hoglet67/AtomBusMon/README.md

# ICE-T65 / ICE-T80 / ICE-6809

This project is an open-source In-Circuit Emulator for the 6502, 65C02, Z80, 6809 and 6809E 8-bit processors.

For further details see the GitHub Project Wiki:
https://github.com/hoglet67/AtomBusMon/wiki

If you have any questions or feedback, please join in the discussion thread at stardot.org.uk:
http://stardot.org.uk/forums/viewtopic.php?f=44&t=9655
