hoglet67/AtomBusMon/(threads)

Thread 3 (2019-03-29):

Add support 1801BM1 Soviet PDP-11 CPU.

xolod79, 2019-03-29:
Thank you for a very interesting project!
I want to ask you whether you can add support for CPU 1801BM1 in your project.
There is a working model of it https://github.com/1801BM1/cpu11/blob/master/readme.md with configuration for Xilinx devboard
I think that you can transfer it to the GODIL board quickly.
I understand that adding debugging tools is much more difficult. But perhaps gradually it can be done by joint efforts.
If you are interested, I can send you the original of this CPU.

hoglet67, 2019-03-29:
This is not something I'll be able to take on in the short term. I've got too many other projects on the go at the moment. Also, I don't have any experience of this CPU, and no systems that use it. So that's going to make it hard as well. Sorry!

hoglet67, 2019-03-29:
(I'll leave this issue open in case someone else wants to tackle it)

xolod79, 2019-03-29:
Thanks for the answer.
If it will be interesting. Here are some articles on the second model of this CPU.
https://hackaday.io/project/67369/logs?sort=oldest

jessaskey, 2021-04-03:
@xolod79 , I would be interested in trying to add another CPU core to Davids existing codebase in this direction... My cpu is a DEC T-11 is a tad different but in the same 'family'... the soviets cloned the T11 as the KE1807VM1 - https://en.wikipedia.org/wiki/DEC_T-11

and the core I found which might be a template is here.... https://opencores.org/projects/w11

xolod79, 2021-04-03:
hello @jessaskey! I love your interest in porting DEC T11 to Atom Bus! I have a Soviet computer Electronics MC0515 with KR1807VM1 as a CPU. http://www.leningrad.su/museum/show_calc.php?n=267&lang=0&test=0
And I can test the results obtained if you wish.
Yes, of course, you will have to expand the work of the respected @ hoglet67 to integrate the 16bit CPU DEC, but I suppose that there should not be something very complicated there.
I also want to draw your attention to the project https://github.com/1801BM1/cpu11 where, using DECAP and reverse engineering, accurate transistor circuits and Verlog LSI-11 and original Soviet PDP-11 CPUs were obtained. Also the author of the project will soon complete the DEC F-11.

jessaskey, 2021-04-04:
Just to put this link here for reference... here the best source for T-11 datasheets...  http://bitsavers.informatik.uni-stuttgart.de/pdf/dec/pdp11/t11/

when I have time, I will start looking at this and how it might fit onto an EEPIZZA Spartan, then start trimming the above core down.

Thread 4 (2019-04-02):

ICE-Z80 and the Micro-Professor MPF-1

AFA58, 2019-04-02:
Maybe I look wring,but I can not find an index of wikipages that are here. I am going to build a ICE-Z80 with a 500. What I found until now is:
https://github.com/hoglet67/AtomBusMon/wiki		HOME
https://github.com/hoglet67/AtomBusMon/wiki/Compiling-firmware
https://github.com/hoglet67/AtomBusMon/wiki/Firmware-Overview
https://github.com/hoglet67/AtomBusMon/wiki/Toolchain
https://github.com/hoglet67/AtomBusMon/wiki/ICE-T80
Is there more available?

And something else:
I like the adapter board that  joeyoravec made, see page 21 of stardot.org. Tobe able to contact him, you need to register as a member on stardot.org. The registration has to be approved. I guess there is nobody homeanymore because the registrattion does not proceed, so I can  not contact joeyoravec.
Any suggestion on this?  His adapterboard looks cool

hoglet67, 2019-04-02:
There are 19 pages on the Wiki; all can be seen in the sidebar on the right of the Wiki.

Are you not seeing this navigation aid?

hoglet67, 2019-04-02:
What user name did you register under - I'll get it approved for you.

AFA58, 2019-04-03:
Hi David,

Name is AFA58. Now I see i was using IE. When I use opera I see the
sidebar with the content.

I could not understand why I did not see, I guess IE messes it up. (Need
it for work though, so what can you do)

Thanks!

Ton

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

Links:
------
[1]
https://github.com/hoglet67/AtomBusMon/issues/4#issuecomment-479180105
[2]
https://github.com/notifications/unsubscribe-auth/AEXiv_5rOQ1U-VnkN9VZCBf7Wj3hnJKDks5vc7oPgaJpZM4cY_c0

AFA58, 2019-04-06:
Hi David,

According to the wiki pages you install Xilinx ISE 14.7 on Ubuntu 14.04.

When I do that the USB cable can not work because the windrv6 is not
installed.

Checking Google gives many pages but no solution, I knowafter three/four
hours.

How didyou get the USB Cable to work in this set up?

Regards,
Ton

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

Links:
------
[1]
https://github.com/hoglet67/AtomBusMon/issues/4#issuecomment-479180105
[2]
https://github.com/notifications/unsubscribe-auth/AEXiv_5rOQ1U-VnkN9VZCBf7Wj3hnJKDks5vc7oPgaJpZM4cY_c0

hoglet67, 2019-04-07:
You need to compile and install a third-party USB cable driver (called "libusb-driver")

There are lots of instructions for this on the web, but they do var depending on the exact version of Ubuntu that you are using, and whether it's 32-bit or 64-bit.

Try this one:
https://www.george-smart.co.uk/fpga/xilinx_jtag_linux/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

AFA58, 2019-04-16:
The first link worked like a charm, I am able to use the cable now.
Thanks!

First I programmed the 500-GODIL with blank.mcs and after that with avrz80cpu.mcs. When I power up the GODIL I receive the startup message on the serial port, free running CPU, and I can get a working prompt.

I made a adapter PCB so the two 50P female connectors on the bottom of the GODIL are connected to a 40P DIP socket. (Aligned by the VCC and GND pins, leaving the top 3 and bottom 2 pinrows of the 50P empty)

I expect the thing to run then. For testing I use a Micro Professor, which is a very basic Z80 system, 1,7Mhz, no buffering of Address or Databus, other than 10K pull-ups on the databus.

But it does not run. The MPF does not start up and I do not see any activity on any pin. When I do a memdump I only see 00 everywhere.

Am I missing something? Is programming with avrz80cpu.mcs all I have to do, or is there more?

hoglet67, 2019-04-16:
Programming with  avrz80cpu.mcs is all you should need to do.

When you do a memory dump at location 0 I would expect you would see the ROM.

So something is not right.

In the serial console, can you do the following:
- <hit return to get to interactive mode>
- reset
- regs
- step 10
- regs
- continue

and post a log of the full session.

Do you have access to an oscilloscope?

AFA58, 2019-04-16:
I think I know what is wrong: I expected that the dip40 would follow the pinning of the two 50P connectors.

That leaves 3 empty pins on the top free and two on the bottom.

BUT.. on the schematics, now I see that C13 is connected to pin49, and D13 is connected to pin50.
(C13 and D13 being pins on the two 50P female connectors.

That means that the Pin1 to 10 of the z80, and also pin 31 to 40 are wired wrong, they should go to one pin higher of the 50P headers. (C13 and D13 should have been left unconnected).
Weird why pin49 and pin50 are put inbetween on the D50 connectors, but not on the DIL40. I should have seen it on the schematics though... But in dutch it is "in hindsight you look the cow in its ass".

Anyway, two options: Solder a new adapter PCB. (but more difficult because of the 1 pin offset on the top-half)  Or changing the pinning of the emulated Z80 to include the pin49 and pin50. And rebuild etc. (Need to read into that, whether that is easy)

hoglet67, 2019-04-16:
The symptoms you reported were consistent with the core not receiving a clock.

Changing the pinout in the .ucf file to mach your adaptor should be possible.

Just edit the LOC= values in this file:
https://github.com/hoglet67/AtomBusMon/blob/master/target/godil_500/icez80/board.ucf

hoglet67, 2019-04-16:
Table 6 in the GODIL manual details the pin assignments.
https://www.trenz-electronic.de/fileadmin/docs/OHO-Elektronik/TE0261-GODIL/archive/UM_GODIL-v090.pdf#page=21

You''ll just need be very careful and methodical.

hoglet67, 2019-04-20:
Any luck with getting this working yet AFA58?

AFA58, 2019-04-20:
Biggest hurdle was to get the wife off the PC that I installed the virtual Ubuntu.
I first had issues with licstdc++.so.6 but solved them. Then had an issue with Data2mem, solved that too.
Tried to get it to work using pin 49 and 50, but they are the wrong type of pin, so the build failed.
Then connected the pins that were on 49 and 50 to the pins that are on the third row from above. (I do not have the exact data here now) So I had to solder a bit, but not too difficult. Built, flashed and into the Micro Professor and I got the UPF-1 startup display! It is still a bit unstable, but from previous measuremenrs with the scope I know the databus looks horrible. I did not have the time yet to connect a terminal to the serial port while in the Micro professor, but that will come.
So good progress, and getting there.

AFA58, 2019-04-22:
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

Something is going right :-)  When I have a command prompt the keyboard and display scanning stops and I have these results. When I  "c"ontinue  the display starts acting weird and the program loses track..

hoglet67, 2019-04-22:
That's good progress.

Does it run reliably in free-running mode?

What happens if you try the following:
```
<press enter to get to command prompt>
trace 1
reset
regs
step 100
regs
trace 0
step 10000000
```

AFA58, 2019-04-22:
>> trace 1
Tracing every 1 instructions while single stepping
>> reset
Resetting CPU
00.000003: 0000 : LD   B,$00
>> regs
Z80 Registers:
   AF=FFFF  BC=0008  DE=E062  HL=1FE6
  'AF=FFFF 'BC=6906 'DE=F9C2 'HL=05E6
   IX=1F01  IY=18CD  PC=0000  SP=FFFF I=00 R=00 IFF=00
  Status: SZIH-P-C
>> step 300
Stepping 300 instructions ### Did 300 because of the DJNZ at 0002
00.000010: 0002 : DJNZ $0002
00.000023: 0002 : DJNZ $0002
00.000036: 0002 : DJNZ $0002
00.000049: 0002 : DJNZ $0002
00.000062: 0002 : DJNZ $0002 +Took some out here
00.003325: 0002 : DJNZ $0002
00.003333: 0004 : LD   A,$90
00.003340: 0006 : OUT  ($03),A
00.003351: 0008 : LD   A,$C0
00.003358: 000A : OUT  ($02),A
00.003369: 000C : LD   SP,$1FAF
++ Here NMI kicks in. there is a circuit that generates NMI's every 5 MI's,controlled by in IO line.
++ I guess that does something
00.003382: 0066 : LD   ($1FE7),A
00.003395: 0069 : LD   A,$90
00.003402: 006B : OUT  ($03),A
00.003413: 006D : LD   A,$C0
00.003420: 006F : OUT  ($02),A
00.003431: 0071 : LD   A,($1FE7)
00.003444: 0066 : LD   ($1FE7),A
00.003457: 0069 : LD   A,$90
00.003464: 006B : OUT  ($03),A
00.003475: 006D : LD   A,$C0
00.003482: 006F : OUT  ($02),A
00.003493: 0071 : LD   A,($1FE7)
00.003506: 0066 : LD   ($1FE7),A
00.003519: 0069 : LD   A,$90
00.003526: 006B : OUT  ($03),A
00.003537: 006D : LD   A,$C0
00.003544: 006F : OUT  ($02),A
00.003555: 0071 : LD   A,($1FE7)
00.003568: 0066 : LD   ($1FE7),A
00.003581: 0069 : LD   A,$90
00.003588: 006B : OUT  ($03),A
00.003599: 006D : LD   A,$C0
00.003606: 006F : OUT  ($02),A
00.003617: 0071 : LD   A,($1FE7)
00.003630: 0066 : LD   ($1FE7),A
00.003643: 0069 : LD   A,$90
00.003650: 006B : OUT  ($03),A
00.003661: 006D : LD   A,$C0
00.003668: 006F : OUT  ($02),A
00.003679: 0071 : LD   A,($1FE7)
00.003692: 0066 : LD   ($1FE7),A
00.003705: 0069 : LD   A,$90
00.003712: 006B : OUT  ($03),A
00.003723: 006D : LD   A,$C0
00.003730: 006F : OUT  ($02),A
00.003741: 0071 : LD   A,($1FE7)
00.003754: 0066 : LD   ($1FE7),A
00.003767: 0069 : LD   A,$90
00.003774: 006B : OUT  ($03),A
>> regs
Z80 Registers:
   AF=90FF  BC=0008  DE=E062  HL=1FE6
  'AF=FFFF 'BC=6906 'DE=F9C2 'HL=05E6
   IX=1F01  IY=18CD  PC=006B  SP=FFF1 I=00 R=2C IFF=00
  Status: SZIH-P-C
>> trace 0
Tracing disabled
>> step 1000000
Stepping 1000000 instructions # did some less no change
12.028907: 0637 : DJNZ $0637
++ 0637 is right in the middle of the display scan routine

hoglet67, 2019-04-22:
Something is definitely going wrong early in the reset sequence.  It looks like for some reason the NMI handler is being called re-entrantly, which will end up overflowing the stack.

On a power-on reset, would you expect any NMIs to be generated?

I'm not familiar with the MicroProfessor, but it seems NMI is used by the monitor to support:
- single stepping
- break

It might be worth checking the level on the 8255 PC6 output, before and after the instruction at 000A is executed.

Do you know of a MicroProfessor clone or replica? I would beed to get hold of some hardware myself to try to better understand why this is failing.

Dave

hoglet67, 2019-04-23:
I've been thinking about this issue some more.

The sequence in trace you reported that's concerning me is:
```
00.003333: 0004 : LD A,$90
00.003340: 0006 : OUT ($03),A
00.003351: 0008 : LD A,$C0
00.003358: 000A : OUT ($02),A
00.003369: 000C : LD SP,$1FAF
<NMI happens here>
```
The instruction at 000A should set PC6 to 1, holding the 74LS90 counter in reset, and disabling the NMI function.  Instead, it looks like the earlier OUT ($03),A instruction is releasing the 74LS90 counter, but the NMI happens only 4 instructions later. It seems the OUT ($02),A is not having an effect, or is not having time to have an effect.

What I suspect is happening is there is a bug in the ICE Z80 in the way that M1 is generated when single stepping, that results in multiple transitions on M1. This would cause the NMI to happen earlier than expected when single stepping.

Looking at the VHDL, I can see one possibility for how this might happen, if the Z80 core happens to be stopped on a T state where M1 is low.

I'll see if I can replicate this behaviour locally.

In the mean time, there are a couple more simple experiments you could try, that will help support the above hypothesis:

1. Does it run normally from power up (if you do nothing in the ICE Z80 command line)?

2. Does it run normally if you do the following:
```
<press return to enter interactive mode>
reset
c
```

3. What do you see if you do the following:
```
<press return to enter interactive mode>
reset
watch 0066
c
```
 (i.e. do you see any NMIs happening)

4. Can you set a breakpoint after the code to disable the BREAK function, and then single step without NMIs happening:
```
<press return to enter interactive mode>
reset
watch 0066
break 000f
c
<hopefully a ICT Z80 will happen>
s 100
```
Many thanks for feeding back this issue. We'll definitely get to the bottom of it one way or another.

Dave

hoglet67, 2019-04-23:
Incidentally, there is a nice description of how the NMI system in the MPF-1 works here:
http://www.math-cs.gordon.edu/courses/cs222/lectures/MPFI-lab-intro.html
(search for NMI:)

AFA58, 2019-04-23:
Hi Dave,

From your questions, number 1: No it does not run normally, it is unstable.

To avoid the NMI problem, I (temporarily) cut the trace of the BREAK, so PC6 is not in control anymore. I checked with the Z80 in place and have a normal operating MPF except for the STEP key.

When I step with 100 or 200 or so steps while in the display loop, I can see the digits one by one light up. When I press a key,(which are read by the same loop) the speaker burps for a while (the beep is spoiled by the stepping) and then basically things get lost. Sometimes the message Err-SP appears, sometimes just spurious data on the display. I do not think RAM data is well read/written.
But I did not have time to investigate more tonight.

I do not know of a clone. I bought mine on ebay. There is a french guy who has (had?) some.

hoglet67, 2019-04-23:
The general instability is not good news, and is a bit unusual. In one of your earlier posts I think I saw you run a RAM test, and there were failures. That's probably worth further investigation.

Can you repeat the RAM test, say 10 times, and post the results.

With the ICE Z80 running, is the 5V rail good, i.e. close to 5V with minimal noise?

Dave

AFA58, 2019-05-06:
Hi Dave,

Progress..
There are two static rams in my board. On the location 1800-1fff there was a AM9128-20, and on the 2000-27ff expansion area there was an MSM5128-15.
I took out the -20 and put the -15 in the 1800-1fff socket because there is the stack. Now it is much more stable.
On the normal clockspeed I can operate the MPF with some problems:
- Occasionally it goes wild and the speaker keeps bleeping. (Maybe it will stop sometime, but I resetted after a couple of seconds)
- Normally you enter a program in area 1800 and up..  The very simple example program works, but on certain addresses it shows eg. F803 instead of 1803. So the highest nibble seems to be displayed wrong occasionally
- The Tape WR key actually produces a tape sound that seems valid.
- I do not know if stepping works, did not repair the cut track yet.

The MPF that I bought has a hardware modification built in where the clockspeed can be divided by 4. So instead of the 1.79MHZ it will be 1.79/4 = 447Khz
In that mode the MPF works ok. (But too slow scanning and beep)

So there seems to be an issue with ram-timing. I noticed in the schematics that the RAM is wired without RD.
Would that cause this behaviour?

Regards,
Ton
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

hoglet67, 2019-05-06:
It's possible this instability is related to OE being tied low. In this configuration, bus conflicts can arise in the periods either side of the write pulse:
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
With OE held low, the RAM and the Z80 will  both be driving the bus at the same time.

The period after the write is less of an issue, as both should be driving the same value. But before the write is more of a problem, because the values could differ.

During these conflicts, quite large currents can flow. The FPGA design (in the .ucf file) deliberately limits the drive to 8mA per I/O. But that's more to prevent damage than to guarantee correct operation.

I'm not really an expert on Z80 designs, but I would have expected OE to be connected to the Z80 nRD signal. But possibly this would need faster RAM.

AFA58, 2019-05-06:
Ok, a quick test (bending out of socket pin 20, wiring it to RD) with the slow RAM IC did not give a better result. Did not want to do that with the -15, I wil find a way to test with that one without bending.

hoglet67, 2019-10-29:
@AFA58

Sorry it has been a long time, but I now have a Micro Professor MPF-1B.

1. RAM Instability

The RAM fitted is a Sharp LH-5116-15. I also tried a Hitachi HM6116LP-3 (150ns) and a Mostek MK4118A-4 (250ns). All worked perfectly and I was able to run the RAM test program 10 times without any failures.

However, my MPF 1B was manufactured in 1989, and the schematic is slightly different to the one you posted above. It seems to match the one in this scan of the manual:
http://www.1000bit.it/support/manuali/multitech/MPF-I-User's-manual.pdf

Most notable, OE on the RAM is connected to CE.

As a test, I bent out pin 20 (OE) of the LH-5116-15 and connected it to 0V, replicating I think how the memory is wired on your board. With that change in place, I do see a memory test failure:
```
>> test 1800 1fff
Memory test: Fixed 55: passed
Memory test: Fixed AA: passed
Memory test: Fixed FF: passed
Memory test: Fixed 00: passed
Memory test: Checkerboard: passed
Memory test: Inverse checkerboard: passed
Memory test: Address pattern: passed
Fail at 1DDE (Wrote: FF, Read back 00)
Memory test: Inverse address pattern: failed: 1 errors
Memory test: Random: passed
Memory test: Random: passed
Memory test: Random: passed
```
I also tried this same change with the HM6116LP-3, but did nor see any memory failures.

The fact that Multitech updated the design does suggest there were issues with the earlier version with certain RAM devices.

2. Single Stepping bug

Earlier in the issue I suggested a possible cause for this:

> What I suspect is happening is there is a bug in the ICE Z80 in the way that M1 is generated when single stepping, that results in multiple transitions on M1. This would cause the NMI to happen earlier than expected when single stepping.
>
>  Looking at the VHDL, I can see one possibility for how this might happen, if the Z80 core happens to be stopped on a T state where M1 is low.

I verfied that this is indeed the case. The version of ICE-Z80 you are have uses WAIT internally to pause the Z80 in M1/T2. In this state M1, is low. When the ICE makes memory accesses during single stepping, these to end up raising and lowering M1. This is why NMI on the MPF-1 is being triggered early.

There is a new version of ICE-Z80 in the dev branch that addresses this issue, and also addesses many other problems. In particular, it stops the Z80 in M1/T3 when M1 is high. So there are no extra M1 transitions when single stepping.

With this version, single stetting (on the ICE) no longer crashes when the single step function (on the MPF) is used. But currently the NMI happens one cycle too late:
```
13.430491: 02DC : OUT  ($02),A
13.430503: 02DE : LD   A,($1FBD)
13.430517: 02E1 : JP   $1FEB
13.430528: 1FEB : DI
13.430533: 1FEC : RET
13.430544: 1800 : LD   A,$05
13.430552: 1802 : LD   B,$04
13.430564: 0066 : LD   ($1FE7),A
13.430578: 0069 : LD   A,$90
13.430586: 006B : OUT  ($03),A
13.430598: 006D : LD   A,$C0
13.430606: 006F : OUT  ($02),A
```
So two user instructions are executed before the NMI kicks in. This only seems to happen when the instructions are logged. I need to investigate this further.

I've also been working on a new hardware platform to replace the obsolete GODIL, using a cheap XC6SLX9 board and an active level shifter design:
https://github.com/hoglet67/AtomBusMon/wiki/Z80-CPU-Adapter

So far this has been tested on the following systems:
- ZX81
- ZX Spectrum 48K (Issue 4S)
- ZX Spectrum +2B
- Acorn External Z80 Co Processor
- CPC 464
- Micro Professor MPF-1

You can also build the version for the GODIL-500.

Unfortunately, due to the latest version of the T80 core being 10% larger, it no longer fits in GODIL-250. I'll be getting a GODIL-500 tomorrow, so should be able to confirm that it works in the MPF as well.

Dave

hoglet67, 2019-10-29:
NMI cycles are logged now, so it's a bit clearer what's going on:
```
>> br 1feb
Ex Brkpt set at 1FEB
>> d 1800
1800 : LD   A,$05
1802 : LD   B,$04
1804 : ADD  A,B
1805 : LD   ($1830),A
1808 : HALT
1809 : RST  7
180A : RST  7
180B : RST  7
180C : RST  7
180D : RST  7
>> c
CPU free running...
Ex Brkpt hit at 1FEB
Interrupted
04.012903: 1FEB : DI
>> s8
Stepping 8 instructions
04.012908: 1FEC : RET
04.012919: 1800 : LD   A,$05
04.012927: 1802 : **NMI**
04.012939: 0066 : LD   ($1FE7),A
04.012953: 0069 : LD   A,$90
04.012961: 006B : OUT  ($03),A
04.012973: 006D : LD   A,$C0
04.012981: 006F : OUT  ($02),A
>> c
CPU free running...
Ex Brkpt hit at 1FEB
Interrupted
09.417163: 1FEB : DI
>> s8
Stepping 8 instructions
09.417168: 1FEC : RET
09.417179: 1802 : LD   B,$04
09.417187: 1804 : **NMI**
09.417199: 0066 : LD   ($1FE7),A
09.417213: 0069 : LD   A,$90
09.417221: 006B : OUT  ($03),A
09.417233: 006D : LD   A,$C0
09.417241: 006F : OUT  ($02),A
```

INT cycles are also logged

```
>> br 1800
Ex Brkpt set at 1800
>> d 1800
1800 : EI
1801 : NOP
1802 : JP   $1801
1805 : RST  7
1806 : RST  7
1807 : RST  7
1808 : RST  7
1809 : RST  7
180A : RST  7
180B : RST  7
>> c
CPU free running...
Ex Brkpt hit at 1800
Interrupted
00.278795: 1800 : EI
>> s 16
Stepping 16 instructions
00.278800: 1801 : NOP
00.278805: 1802 : JP   $1801
00.278816: 1801 : NOP
00.278821: 1802 : JP   $1801
00.278832: 1801 : NOP
00.278837: 1802 : JP   $1801
00.278848: 1801 : NOP
00.278853: 1802 : JP   $1801
00.278866: 1801 : **INT**
00.278878: 0038 : PUSH HL
00.278890: 0039 : LD   HL,($1FEE)
00.278907: 003C : EX   HL,(SP)
00.278927: 003D : RET
00.278938: 0066 : LD   ($1FE7),A
00.278952: 0069 : LD   A,$90
00.278960: 006B : OUT  ($03),A
```

hoglet67, 2019-10-30:
Just to clarify something I said eariler regarding updated MPF-1 schematic in this version of the manual:
http://www.1000bit.it/support/manuali/multitech/MPF-I-User's-manual.pdf

Looking at the schematic, pin 20 (OE) appears twice on U8:
- at the bottom, connected to pin 18 (CE)
- at the top, connected to the Z80 RD

Measuring the actual board, pin 20 is connected to the Z80 RD signal.

This make sense, as otherwise there will be brief periods of bus conflict around writes.

Dave

Closed 2019-11-03.

Thread 5 (2019-05-20):

Fill command, fill in one byte more than necessary

xolod79, 2019-05-20:
Fill command, fill in one byte more than necessary
On Z80
>> fill 4000 40ff ff
but 4100 filling too

hoglet67, 2019-05-20:
I've just checked the code, and I can't see the error:
```
void doCmdFill(char *params) {
  long i;
  unsigned int start;
  unsigned int end;
  unsigned int data;
  sscanf(params, "%x %x %x", &start, &end, &data);
  log0("Wr: %04X to %04X = %02X\n", start, end, data);
  loadData(data);
  loadAddr(start);
  for (i = start; i <= end; i++) {
    writeMemByteInc();
  }
}
```
Can you attach a log the demonstrates this happening please?

xolod79, 2019-05-20:
Maybe the date should be a data 16bit word and not byte?

hoglet67, 2019-05-20:
Please can you attach a log, and I'll look into this.

xolod79, 2019-05-21:
It seems that the problems with my Godil50 board, I solder it by swapping the connectors up and was sloppy.
Installed it in the ZX-Spectrum (Pentagon 128), partially launches but hangs. launched a memory test.
test 8000 ffff
produces a lot of errors with some sort of bit address relationship.

xolod79, 2019-06-14:
iI apologize. The problem was in the zx-spectrum board (Pentagon 128). I plan to put the buffer(74ALS245) on the data bus. I think it should work with him.

hoglet67, 2019-06-14:
Thanks for letting me know.

Closed 2019-06-14.

Thread 7 (2019-11-04):

Improve missing parameter checking on commands

hoglet67, 2019-11-04:
The following commands need attention:
- fill
- crc
- test
- trace
- wrm/wri

Closed 2019-11-15.

Thread 12 (2019-11-12):

Add go command

hoglet67, 2019-11-12:
To force the CPU to start executing at a given location.

There are a couple of approaches to consider:
1. Extend the CPU core to support register writing on the debug interface (T80 already has this)
2. Force a JMP xxxx command onto the CPU core data bus

hoglet67, 2019-11-15:
In the 6502/65C02 I've added go and exec commands, which work by forcing opcode values onto the 6502 data bus.

It was quite involved to do this and there are race conditions with interrupts.

I'm not sure if I'm going to add this to the Z80 and 6809.

Let's see if it's every actually useful!

obiwanjacobi, 2019-11-15:
Are there command to set register values? (a quick scan of the wiki says no)
Jumping to an address is nice and all, but usually the contents of the register can matter quite a bit...

hoglet67, 2019-12-13:
No, currently it's not possible to set a register value.

This would be possible, but it would require some customizations to each core.

Thread 15 (2019-11-12):

Add more detailed help

hoglet67, 2019-11-12:
This may cause us to overflow 16KB again

Do this in a way that can be disabled in the godil_250 builds, using a flag in the Makefile.

obiwanjacobi, 2019-11-13:
Make (github.io) internet pages that have the extended text. Report small error texts with a short link to these help pages?

hoglet67, 2019-11-13:
Managed to fit this in quite easily:
```
ICE-65C02 In-Circuit Emulator version 0.96
Compiled at 19:18:40 on Nov 13 2019
8 watches/breakpoints implemented
Commands:
    blist
    breakr    <address> [ <mask> [ <trigger> ] ]
    breakw    <address> [ <mask> [ <trigger> ] ]
    breakx    <address> [ <mask> [ <trigger> ] ]
    clear     <address>
    compare   <start> <end> <to>
    continue  [ <reset> ]
    copy      <start> <end> <to>
    crc       <start> <end>
    dis       [ <start> [ <end> ] ]
    fill      <start> <end> <data>
    flush
    help      [ <command> ]
    history
    load      <address>
    mem       [ <address> ]
    next
    rd        [ <address> [ <count> ] ]
    regs
    reset
    save      <start> <end>
    special   [ <value> ]
    srec
    step      [ <instructions> ]
    test      <start> <end> [ <test num> ]
    trace     [ <instructions> ]
    trigger   [ <address> <trigger> ]
    watchr    <address> [ <mask> [ <trigger> ] ]
    watchw    <address> [ <mask> [ <trigger> ] ]
    watchx    <address> [ <mask> [ <trigger> ] ]
    wr        <address> <data> [ <count> ]
>> help load
    load      <address>
>> help save
    save      <start> <end>
>>
```

Closed 2019-11-13.

Thread 16 (2019-12-15):

New firmware version for GODIL500

xolod79, 2019-12-15:
Please, build a new version firmware for GODIL500.

I restored my Godil after burnout of one pin due to improper insertion into the connector.  replacement of the 74CB3T16211 buffer fixed the problem.

hoglet67, 2019-12-15:
I've just done a complete rebuild of all targets, and uploaded a new release here:
https://github.com/hoglet67/AtomBusMon/releases/tag/release_2

That includes 4 builds for the GODIL500:
```
   780476  2019-12-15 17:20   ice_20191215_1612_0981/godil_500/ice6809/ice6809.mcs
   780476  2019-12-15 17:20   ice_20191215_1612_0981/godil_500/icez80/icez80.mcs
   780476  2019-12-15 17:20   ice_20191215_1612_0981/godil_500/ice6502/ice6502.mcs
   780476  2019-12-15 17:20   ice_20191215_1612_0981/godil_500/ice65c02/ice65c02.mcs
```
Please let me know if you encounter any problems.

Dave

xolod79, 2019-12-15:
Thank you.

Closed 2019-12-15.

Thread 17 (2021-01-01):

XC6SLX9 Mini Board no longer avalible

iceblu3710, 2021-01-01:
eepizza on ebay no longer sells the mini board it seems. Is the Mojo V3 a viable alternative?

[https://alchitry.com/products/mojo-v3](https://alchitry.com/products/mojo-v3)

hoglet67, 2021-01-01:
I think it would be a viable alternative, but would require a re-design of each of the CPU adapter boards, as the connector footprint and pinouts are different.

jessaskey, 2021-03-10:
This is the the stardot forums but figured it could go here too... the original EEPIZZA development board is now for sale again on ebay as of Feb 2021. They have a monthly limit, so pay attention for new inventory added. https://www.ebay.com/itm/XC6SLX9-Core-Board-with-UART/114663155388

Seller is now 'rella-engineering' - https://www.ebay.com/usr/rella-engineering?_trksid=p2047675.l2559

Thread 18 (2021-01-01):

Is disassembly via simulated execution or just memory reads?

iceblu3710, 2021-01-01:
I have a piece of test equipment running a z80 I want to repurpose. To figure out how to interface with its hardware I need to disassemble and map IO.

I tried traditional methods like IDA but the manufacture specifically chunked up the asm with random jumps and then filled the inter-spaces with valid opcodes to obfuscate things. To make it even harder there is a PAL that logs IO writes and does a CRC or something to give a jump offset as well.

Does the disassembly instruction run the memory through the processor core or is it just opcode conversion from raw memory? Would single-stepping disassembly be a true view of what the processor is doing?

hoglet67, 2021-01-01:
A single-stepping disassebly is indeed a true view of what the processor is doing.

Do check out another of my projects that might be of use. It's called the Z80 Decoder:
https://github.com/hoglet67/Z80Decoder
https://stardot.org.uk/forums/viewtopic.php?f=3&t=15464

You need a cheap USB logic analyzer (16 bits) and a 40-pin DIP clip. You connect the logic analyzer up to DATA, IORQ, MREQ, M1, RD, WR and CLK pins. You set it to take a sample on the rising edge of the CLK. Capture a dump from the logic analyzer. This can be millions of instructions. Feed that dump through the Z80 decoder and you get an output like this:
```
0A6B : EB              : EX DE,HL             :  3 : A=FF F=  0 0    BC=0004 DE=4096 HL=4099 IX=0281 IY=4000 IR=1E13 M=0A6B SP=43FA
0A6C : E1              : POP HL               : 11 : A=FF F=  0 0    BC=0004 DE=4096 HL=0000 IX=0281 IY=4000 IR=1E14 M=0A6B SP=43FC
0A6D : 19              : ADD HL,DE            :  3 : A=FF F=  0 0    BC=0004 DE=4096 HL=4096 IX=0281 IY=4000 IR=1E15 M=0001 SP=43FC
0A6E :                 : NMI                  : 30 : A=FF F=  0 0    BC=0004 DE=4096 HL=4096 IX=0281 IY=4000 IR=1E17 M=0066 SP=43FA
0066 : 08              : EX AF,AF'            :  3 : A=FE F=S 1 1  C BC=0004 DE=4096 HL=4096 IX=0281 IY=4000 IR=1E18 M=0066 SP=43FA
0067 : 3C              : INC A                :  4 : A=FF F=S 1 1  C BC=0004 DE=4096 HL=4096 IX=0281 IY=4000 IR=1E19 M=0066 SP=43FA
0068 : FA 6D 00        : JP M,006Dh           : 11 : A=FF F=S 1 1  C BC=0004 DE=4096 HL=4096 IX=0281 IY=4000 IR=1E1A M=006D SP=43FA
006D : 08              : EX AF,AF'            :  3 : A=FF F=  0 0    BC=0004 DE=4096 HL=4096 IX=0281 IY=4000 IR=1E1B M=006D SP=43FA
006E : C9              : RET                  : 11 : A=FF F=  0 0    BC=0004 DE=4096 HL=4096 IX=0281 IY=4000 IR=1E1C M=0A6E SP=43FC
0A6E : D5              : PUSH DE              : 11 : A=FF F=  0 0    BC=0004 DE=4096 HL=4096 IX=0281 IY=4000 IR=1E1D M=0A6E SP=43FA
0A6F : ED B0           : LDIR                 : 14 : A=FF F=  1 1V   BC=0003 DE=4097 HL=4097 IX=0281 IY=4000 IR=1E1F M=0A70 SP=43FA
0A6F : ED B0           : LDIR                 : 21 : A=FF F=  1 1V   BC=0002 DE=4098 HL=4098 IX=0281 IY=4000 IR=1E21 M=0A70 SP=43FA
0A6F : ED B0           : LDIR                 : 21 : A=FF F=  0 0V   BC=0001 DE=4099 HL=4099 IX=0281 IY=4000 IR=1E23 M=0A70 SP=43FA
0A6F : ED B0           : LDIR                 : 21 : A=FF F=  1 1    BC=0000 DE=409A HL=409A IX=0281 IY=4000 IR=1E25 M=0A70 SP=43FA
0A71 : E1              : POP HL               : 12 : A=FF F=  1 1    BC=0000 DE=409A HL=4096 IX=0281 IY=4000 IR=1E26 M=0A70 SP=43FC
0A72 : C9              : RET                  : 10 : A=FF F=  1 1    BC=0000 DE=409A HL=4096 IX=0281 IY=4000 IR=1E27 M=048D SP=43FE
048D : 2A 14 40        : LD HL,(4014h)        : 16 : A=FF F=  1 1    BC=0000 DE=409A HL=4097 IX=0281 IY=4000 IR=1E28 M=4015 SP=43FE
0490 : FD 36 00 FF     : LD (IY+0),ffh        : 19 : A=FF F=  1 1    BC=0000 DE=409A HL=4097 IX=0281 IY=4000 IR=1E2A M=4000 SP=43FE
0494 : CD 66 07        : CALL 0766h           : 32 : A=FF F=  1 1    BC=0000 DE=409A HL=4097 IX=0281 IY=4000 IR=1E2B M=0766 SP=43FC
0766 :                 : NMI                  : 11 : A=FF F=  1 1    BC=0000 DE=409A HL=4097 IX=0281 IY=4000 IR=1E2D M=0066 SP=43FA
0066 : 08              : EX AF,AF'            :  3 : A=FF F=S 1 1  C BC=0000 DE=409A HL=4097 IX=0281 IY=4000 IR=1E2E M=0066 SP=43FA
0067 : 3C              : INC A                :  4 : A=00 F= Z0H0  C BC=0000 DE=409A HL=4097 IX=0281 IY=4000 IR=1E2F M=0066 SP=43FA
0068 : FA 6D 00        : JP M,006Dh           : 11 : A=00 F= Z0H0  C BC=0000 DE=409A HL=4097 IX=0281 IY=4000 IR=1E30 M=006D SP=43FA
006B : 28 02           : JR Z,006Fh           :  7 : A=00 F= Z0H0  C BC=0000 DE=409A HL=4097 IX=0281 IY=4000 IR=1E31 M=006F SP=43FA
006F : 08              : EX AF,AF'            :  8 : A=FF F=  1 1    BC=0000 DE=409A HL=4097 IX=0281 IY=4000 IR=1E32 M=006F SP=43FA
0070 : F5              : PUSH AF              : 12 : A=FF F=  1 1    BC=0000 DE=409A HL=4097 IX=0281 IY=4000 IR=1E33 M=006F SP=43F8
0071 : C5              : PUSH BC              : 11 : A=FF F=  1 1    BC=0000 DE=409A HL=4097 IX=0281 IY=4000 IR=1E34 M=006F SP=43F6
0072 : D5              : PUSH DE              : 11 : A=FF F=  1 1    BC=0000 DE=409A HL=4097 IX=0281 IY=4000 IR=1E35 M=006F SP=43F4
0073 : E5              : PUSH HL              : 11 : A=FF F=  1 1    BC=0000 DE=409A HL=4097 IX=0281 IY=4000 IR=1E36 M=006F SP=43F2
0074 : 2A 0C 40        : LD HL,(400Ch)        : 16 : A=FF F=  1 1    BC=0000 DE=409A HL=407D IX=0281 IY=4000 IR=1E37 M=400D SP=43F2
0077 : CB FC           : SET 7,H              :  7 : A=FF F=  1 1    BC=0000 DE=409A HL=C07D IX=0281 IY=4000 IR=1E39 M=400D SP=43F2
0079 : 76              : HALT                 :  4 : A=FF F=  1 1    BC=0000 DE=409A HL=C07D IX=0281 IY=4000 IR=1E3A M=400D SP=43F2
007A :                 : NOP                  :  4 : A=FF F=  1 1    BC=0000 DE=409A HL=C07D IX=0281 IY=4000 IR=1E3C M=400D SP=43F2
007A :                 : NOP                  :  4 : A=FF F=  1 1    BC=0000 DE=409A HL=C07D IX=0281 IY=4000 IR=1E3E M=400D SP=43F2
007A :                 : NOP                  :  4 : A=FF F=  1 1    BC=0000 DE=409A HL=C07D IX=0281 IY=4000 IR=1E40 M=400D SP=43F2
007A :                 : NOP                  :  4 : A=FF F=  1 1    BC=0000 DE=409A HL=C07D IX=0281 IY=4000 IR=1E42 M=400D SP=43F2
007A :                 : NOP                  :  4 : A=FF F=  1 1    BC=0000 DE=409A HL=C07D IX=0281 IY=4000 IR=1E44 M=400D SP=43F2
007A :                 : NOP                  :  4 : A=FF F=  1 1    BC=0000 DE=409A HL=C07D IX=0281 IY=4000 IR=1E46 M=400D SP=43F2
007A :                 : NOP                  :  4 : A=FF F=  1 1    BC=0000 DE=409A HL=C07D IX=0281 IY=4000 IR=1E48 M=400D SP=43F2
007A :                 : NOP                  :  4 : A=FF F=  1 1    BC=0000 DE=409A HL=C07D IX=0281 IY=4000 IR=1E4A M=400D SP=43F2
007A :                 : NOP                  :  4 : A=FF F=  1 1    BC=0000 DE=409A HL=C07D IX=0281 IY=4000 IR=1E4C M=400D SP=43F2
007A :                 : NOP                  :  4 : A=FF F=  1 1    BC=0000 DE=409A HL=C07D IX=0281 IY=4000 IR=1E4E M=400D SP=43F2
007A :                 : NOP                  :  4 : A=FF F=  1 1    BC=0000 DE=409A HL=C07D IX=0281 IY=4000 IR=1E50 M=400D SP=43F2
007A :                 : NOP                  :  4 : A=FF F=  1 1    BC=0000 DE=409A HL=C07D IX=0281 IY=4000 IR=1E52 M=400D SP=43F2
007A :                 : NOP                  :  4 : A=FF F=  1 1    BC=0000 DE=409A HL=C07D IX=0281 IY=4000 IR=1E54 M=400D SP=43F2
007A :                 : NOP                  :  4 : A=FF F=  1 1    BC=0000 DE=409A HL=C07D IX=0281 IY=4000 IR=1E56 M=400D SP=43F2
007A :                 : NOP                  :  4 : A=FF F=  1 1    BC=0000 DE=409A HL=C07D IX=0281 IY=4000 IR=1E58 M=400D SP=43F2
007A :                 : NOP                  :  4 : A=FF F=  1 1    BC=0000 DE=409A HL=C07D IX=0281 IY=4000 IR=1E5A M=400D SP=43F2
007A :                 : NMI                  : 25 : A=FF F=  1 1    BC=0000 DE=409A HL=C07D IX=0281 IY=4000 IR=1E5C M=0066 SP=43F0
0066 : 08              : EX AF,AF'            :  3 : A=00 F= Z0H0  C BC=0000 DE=409A HL=C07D IX=0281 IY=4000 IR=1E5D M=0066 SP=43F0
0067 : 3C              : INC A                :  4 : A=01 F=  0 0  C BC=0000 DE=409A HL=C07D IX=0281 IY=4000 IR=1E5E M=0066 SP=43F0
0068 : FA 6D 00        : JP M,006Dh           : 11 : A=01 F=  0 0  C BC=0000 DE=409A HL=C07D IX=0281 IY=4000 IR=1E5F M=006D SP=43F0
006B : 28 02           : JR Z,006Fh           :  7 : A=01 F=  0 0  C BC=0000 DE=409A HL=C07D IX=0281 IY=4000 IR=1E60 M=006D SP=43F0
006D : 08              : EX AF,AF'            :  3 : A=FF F=  1 1    BC=0000 DE=409A HL=C07D IX=0281 IY=4000 IR=1E61 M=006D SP=43F0
006E : C9              : RET                  : 11 : A=FF F=  1 1    BC=0000 DE=409A HL=C07D IX=0281 IY=4000 IR=1E62 M=007A SP=43F2
007A : D3 FD           : OUT (FDh),A          : 11 : A=FF F=  1 1    BC=0000 DE=409A HL=C07D IX=0281 IY=4000 IR=1E63 M=FFFE SP=43F2
007C : DD E9           : JP (IX)              :  7 : A=FF F=  1 1    BC=0000 DE=409A HL=C07D IX=0281 IY=4000 IR=1E65 M=FFFE SP=43F2
0281 : ED 5F           : LD A,R               :  8 : A=67 F=  1 1    BC=0000 DE=409A HL=C07D IX=0281 IY=4000 IR=1E67 M=FFFE SP=43F2
0283 : 01 01 19        : LD BC,1901h          : 12 : A=67 F=  1 1    BC=1901 DE=409A HL=C07D IX=0281 IY=4000 IR=1E68 M=FFFE SP=43F2
0286 : 3E F5           : LD A,F5h             :  7 : A=F5 F=  1 1    BC=1901 DE=409A HL=C07D IX=0281 IY=4000 IR=1E69 M=FFFE SP=43F2
0288 : CD B5 02        : CALL 02B5h           : 17 : A=F5 F=  1 1    BC=1901 DE=409A HL=C07D IX=0281 IY=4000 IR=1E6A M=02B5 SP=43F0
02B5 : ED 4F           : LD R,A               :  7 : A=F5 F=  1 1    BC=1901 DE=409A HL=C07D IX=0281 IY=4000 IR=1EF5 M=02B5 SP=43F0
02B7 : 3E DD           : LD A,DDh             :  9 : A=DD F=  1 1    BC=1901 DE=409A HL=C07D IX=0281 IY=4000 IR=1EF6 M=02B5 SP=43F0
02B9 : FB              : EI                   :  3 : A=DD F=  1 1    BC=1901 DE=409A HL=C07D IX=0281 IY=4000 IR=1EF7 M=02B5 SP=43F0
02BA : E9              : JP (HL)              :  4 : A=DD F=  1 1    BC=1901 DE=409A HL=C07D IX=0281 IY=4000 IR=1EF8 M=02B5 SP=43F0
C07D : 76              : HALT                 :  4 : A=DD F=  1 1    BC=1901 DE=409A HL=C07D IX=0281 IY=4000 IR=1EF9 M=02B5 SP=43F0
C07E :                 : NOP                  :  4 : A=DD F=  1 1    BC=1901 DE=409A HL=C07D IX=0281 IY=4000 IR=1EFB M=02B5 SP=43F0
C07E :                 : NOP                  :  4 : A=DD F=  1 1    BC=1901 DE=409A HL=C07D IX=0281 IY=4000 IR=1EFD M=02B5 SP=43F0
C07E :                 : NOP                  :  4 : A=DD F=  1 1    BC=1901 DE=409A HL=C07D IX=0281 IY=4000 IR=1EFF M=02B5 SP=43F0
C07E :                 : NOP                  :  4 : A=DD F=  1 1    BC=1901 DE=409A HL=C07D IX=0281 IY=4000 IR=1E81 M=02B5 SP=43F0
C07E :                 : NOP                  :  4 : A=DD F=  1 1    BC=1901 DE=409A HL=C07D IX=0281 IY=4000 IR=1E83 M=02B5 SP=43F0
C07E :                 : NOP                  :  4 : A=DD F=  1 1    BC=1901 DE=409A HL=C07D IX=0281 IY=4000 IR=1E85 M=02B5 SP=43F0
C07E :                 : NOP                  :  4 : A=DD F=  1 1    BC=1901 DE=409A HL=C07D IX=0281 IY=4000 IR=1E87 M=02B5 SP=43F0
C07E :                 : NOP                  :  4 : A=DD F=  1 1    BC=1901 DE=409A HL=C07D IX=0281 IY=4000 IR=1E89 M=02B5 SP=43F0
C07E :                 : INT                  : 14 : A=DD F=  1 1    BC=1901 DE=409A HL=C07D IX=0281 IY=4000 IR=1E8B M=0038 SP=43EE
0038 : 0D              : DEC C                :  3 : A=DD F= Z0 0 N  BC=1900 DE=409A HL=C07D IX=0281 IY=4000 IR=1E8C M=0038 SP=43EE
0039 : C2 45 00        : JP NZ,0045h          : 11 : A=DD F= Z0 0 N  BC=1900 DE=409A HL=C07D IX=0281 IY=4000 IR=1E8D M=0045 SP=43EE
003C : E1              : POP HL               : 10 : A=DD F= Z0 0 N  BC=1900 DE=409A HL=C07E IX=0281 IY=4000 IR=1E8E M=0045 SP=43F0
003D : 05              : DEC B                :  3 : A=DD F=  0 1 N  BC=1800 DE=409A HL=C07E IX=0281 IY=4000 IR=1E8F M=0045 SP=43F0
003E : C8              : RET Z                :  8 : A=DD F=  0 1 N  BC=1800 DE=409A HL=C07E IX=0281 IY=4000 IR=1E90 M=0045 SP=43F0
003F : CB D9           : SET 3,C              :  4 : A=DD F=  0 1 N  BC=1808 DE=409A HL=C07E IX=0281 IY=4000 IR=1E92 M=0045 SP=43F0
0041 : ED 4F           : LD R,A               :  8 : A=DD F=  0 1 N  BC=1808 DE=409A HL=C07E IX=0281 IY=4000 IR=1EDD M=0045 SP=43F0
0043 : FB              : EI                   :  5 : A=DD F=  0 1 N  BC=1808 DE=409A HL=C07E IX=0281 IY=4000 IR=1EDE M=0045 SP=43F0
0044 : E9              : JP (HL)              :  4 : A=DD F=  0 1 N  BC=1808 DE=409A HL=C07E IX=0281 IY=4000 IR=1EDF M=0045 SP=43F0
C07E : 76              : HALT                 :  4 : A=DD F=  0 1 N  BC=1808 DE=409A HL=C07E IX=0281 IY=4000 IR=1EE0 M=0045 SP=43F0
C07F :                 : NOP                  :  4 : A=DD F=  0 1 N  BC=1808 DE=409A HL=C07E IX=0281 IY=4000 IR=1EE2 M=0045 SP=43F0
C07F :                 : NOP                  :  4 : A=DD F=  0 1 N  BC=1808 DE=409A HL=C07E IX=0281 IY=4000 IR=1EE4 M=0045 SP=43F0
```

iceblu3710, 2021-01-02:
That's a really interesting project, I will definitely take a look as I have all the hardware required. I like the BusMon project for a more direct approach after a passive investigation.

If I add an AVR8 routine to the project I can single step, display the disassembly, and list the registers to make the same output as above. I am thinking of making the output dump and run a single step and log to a file. I can then load it in Ghidra and do some high-level analysis.

Most of my projects are old test equipment from the 80's and as such are very over engineered, no documentation and fun to make do things it was never designed for!

iceblu3710, 2021-01-02:
> Capture a dump from the logic analyzer

Is the Z80Decoder file just the capture file pulled from the sigrok project save file?

hoglet67, 2021-01-02:
I don't know anyything about the project save file.

Originally I used sigrok-cli to generate a binary capture file:
```
sigrok-cli -d fx2lafw --config samplerate=12MHz:captureratio=1  -o data.bin -O binary  --samples=48M
```
But for most logic analyzers, sigrok only supports asyncronous capture, and it's generally much better to use synchronous capture (on the rising edge of the Z80 Clock).

What Logic Analyzer do you have?

What Operating Systems do you have access to?

iceblu3710, 2021-01-02:
I have the same cypress dev kit logic analizer as you show in the post pictures. I use Linux primarily so it should work like a treat.

I will move future conversations onto that projects issues tracker.

hoglet67, 2021-01-02:
FYI, If using Linux, I recommend using the fx2pipe capture tool to do synchronous captures (one sample taken on the specified clock edge).

Use the version of fx2pipe from the dev branch here (as it includes some recent fixes):
https://github.com/hoglet67/6502Decoder/tree/dev

To capture on the synchronously rising edge, use the following options:
```
fx2pipe -a -ifclk=i > data.bin
```

You connect the CLK signal to the RDY1 input, and PA4 needs to be connected to GND.

Dave

iceblu3710, 2021-01-04:
These two other projects combined have been an AMAZING benefit to my hobby work over here. I modified fx2pipe to not output the streaming stats so I can pipe it directly into z80decoder. I then pipe that output to a grep or two and I can live stream `IN A` where the received data was NOT `A=00`.

`../fx2pipe -a -d=0925:3881 -ifclk=i | ./decodez80 | grep "IN " | grep -v "A=00"`

I mapped out an entire custom keypad in a few minutes.

hoglet67, 2021-01-04:
Glad to hear you are finding this useful.

The original version of fx2pipe supports piping, because the streaming stats are written to standard error.

So this should work as well:
```
../fx2pipe -a -d=0925:3881 -ifclk=i 2> /dev/null | ./decodez80 | grep "IN " | grep -v "A=00"
```
I've used this method myself on occasion:
https://stardot.org.uk/forums/viewtopic.php?p=211500#p211500

Closed 2021-01-02.

Thread 19 (2021-01-01):

MMU Support

iceblu3710, 2021-01-01:
I have a system with (6) 64k rom chips and (2) 64k ram chips an a "novel" custom MMU and messaging structure that allows paging the entire system memory map in/out. When disassembling it is difficult to know what chip I am currently working with.

Is there a way to add an instruction like mbu (memory bank used) and have it just sample 8 spare pins and report a bitfield of the pin statuses? It would be awesome to integrate into the system so `(2)C2B2 : LDA #29` and you know mem2 is active.

hoglet67, 2021-01-01:
Anything is possible, but this sounds like quite a lot of work (I'm just using a standard Z80 VHDL core).

How do you switch banks at the moment?

It might be easier to do this kind of customization with the Z80Decoder (that I mentioned in #18). That's written in standard C, and does memory modelling (with a 64KB address space). It would be straightforward for you to extend this to a 512KB address space if you can program in C.

iceblu3710, 2021-01-01:
I was thinking of adding it to the softAVR8 core. It would only need to be
sampled while the softZ80 is interrupted so speed is not an issue.

I have no fpga experience but if I can map fpga io to a softAVR8 port I can
just do it as an additional doCmd routine.

On Fri., Jan. 1, 2021, 11:40 a.m. David Banks, <notifications@github.com>
wrote:

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

Thread 20 (2021-03-10):

Ability to 'override' memory reads (typically ROM memory) from Software

jessaskey, 2021-03-10:
My secondary use case for an ICE is to troubleshoot new code that is being published and tested on the target hardware. I use MAME with an appropriate hardware driver to do virtual testing first, and then, by burning new ROM's I can test on the target hardware. The ICE allows me to debug that code nicely. However the step of erasing and reprogramming 4-6 ROM's each time takes about 30 minutes and any small change in the compiled code may change all of them.

If I were to remove all the Physical ROM's from the target hardware, which would leave the data bus un-driven. Is there a possibility for the ICE to have a binary file equivalent (stored on the PC or in FPGA memory?) that would effectively 'replace' the CODE being read? In theory it could be the entire 64K memory space but in practice it would be typically a smaller subset of that space (16-32K)

This is eerily similar to the 6502 EXEC command you implemented and my guess is that due to the core structure, having the ability to intercept the Data Bus like this is problematic on the current cores?

I would be willing to help code this under advisement. I do have hardware, assembly and C# skills, just not VHDL or much C proper, but Im a learner!

hoglet67, 2021-03-10:
The work to support this is mostly on the hardware side - the commands to upload code (SREC and LOAD) already exist.

Which FPGA Board are you using?

Unfortunately, there's not really sufficient FPGA Block RAM on the GODIL do this. On the EEPIZZA board, with the larger XC6SLX9 FPGA, you might be able to make 32KB available, if you shrunk the event FIFO.

Another way to do this is to simply replace the ROMs with a small plug-on RAM module, and a flying leader for WE.

Dave

jessaskey, 2021-03-12:
Im on the EEPIZZA. Your point about throwing in some RAM is certainly doable and is a solid idea... I was looking to do it without physical hardware ideally.

Since Im not that familiar with the FPGA code, are there architechtural challenges in order to map CPU Address/Data to that RAM or is it just a matter of getting things set up properly as far as a flag and some defines on the array mapping (and minimizing FIFO like you said).

Im jumping the gun a bit as I don't even have my ICE running yet and communicating with my PC... but I finally got my sockets today so maybe tonight finally!  thank you.

jessaskey, 2021-03-24:
I closed this comment. Im just learning and I wasn't sure my issue was above was appropriate to clog the forums on startdot so I put it here. I understand the proposal you made and I will bring it up again perhaps after I understand more etc.

Another thing to consider is that just a couple weeks ago here on GitHub, the 'Discussions' feature was added as an option for for repositories and so for source code type of conversations it may be useful to turn that feature on?

thank you!

Closed 2021-03-24.

Thread 22 (2021-04-02):

Mask RESET with 'special' command?

jessaskey, 2021-04-02:
In several hardware configurations, either the 6502,6809 or Z-80 are a slave processor. In those situations it is common that if the CPU stops responding to the master CPU, that the Master CPU will reset the slave to try and get it back on track. When doing commands like 'test' or even just interrupting the processor on the ICE, it will force a reset to happen.

I was wondering if it was possible to mask the RESET signal into the CPU core so that it is possible to debug via ICE and ignore any RESETs sent via the input pin? This would be similar to the masking if the IRQ and NMI (and FIRQ on 6809) inputs but would expand to the RESET. I looked at the code and it looks like there may be a 0x7 limit on the mask definitions which would make this more difficult on the 6809?

hoglet67, 2022-02-27:
Masking of the control inputs (including reset) is greatly improved in the latest version.

There is now a set of four "x" commands, one per control input.

On the 6502 they are:
```
   xirq      e|c|d|f
   xnmi      e|c|d|f
   xres      e|c|d|f
   xso       e|c|d|f
```
(On the Z80 and 6809 versions they are renamed appropriately)

The commands take four possible options:
- e = Enabled (the default state - connected to the external signal)
- c = Conditionally enabled (connected to the external signal only when free-running)
- d = Disconnected (connected to a logic 1)
- f = Forced (connected to a logic 0)

jessaskey, 2022-02-27:
Thank you... this is great... I will get my units reprogrammed this week to test out.. appreciate it!

Closed 2022-02-27.

Thread 23 (2021-04-10):

TEST and CRC run very slow when clock missing

jessaskey, 2021-04-10:
I noticed that when I was testing some scripts via the serial port for batch testing, that if the ICE is on a powered down UUT, that these two command will run (which is good), but they are about 100-200x slower. A 'test 0000 0FFF -1' takes about 1 second in place of my 6502B CPU, but when I have the ICE on my PC via USB with no UUT or the UUT is turned off, it will take over 3 minutes to return.

Any chance that if the ICE is in ***missing clock*** mode if these can auto clock or just return a zero result in order to complete in a timely manner?

hoglet67, 2021-04-10:
The timeout (per access) is I think currently fixed and is about 4ms.

I think the best option here is to add a timeout command, and make the timeout programmable.

I can have a go at that today.

Dave

I

hoglet67, 2021-04-10:
I've added a timeout command, that takes a parameter in microseconds (in hex):
https://github.com/hoglet67/AtomBusMon/commit/944f951b189543b0b168ded383fa408a6a50392c

In testing this, I was powering the host on and off, and a couple of times I seemed to get stuck in a state where I was seeing
"memory timeout" errors, even though the host was running.

I don't think this has anything to do with making the timeout programmable. I suspect there is a hardware bug where the memory state machine can end up stuck in an undefined state, possibly due to an unexpected/asynchronous input change. Do let me know if you encounter this issue, and I'll put a bit more effort into tracking it down.

(for reference I saw it with the ICE-65C02)

jessaskey, 2021-04-10:
thank you... I will grab dev tonight (US time)  and give it a runthrough. I was also seeing the memory timeout messages (for crc specifically I believe) but they appeared to be sporadic and the response time did not seem to depend on if there was a memory timeout or not. I will do so diagnostics tonight and report back. thank you!

jessaskey, 2021-04-11:
Okay, this seems to have worked pretty nicely, thanks again. I tried this evening to find a pattern when the memory timeout message appears and I wasn't really able to find anything. I was able to get the 6502 ICE to basically quit responding using these commands (not connected to a UUT).. UPDATE: Oddly, the ICE finally responded after like 10 minutes..  see the very end of the post...

NOTE: Nothing below is very meaningful because I had the ICE not plugged into a DUT, so I think in those circumstances 'mileage may vary' is perfectly acceptable. I never was able to get a memory timeout this evening tho.

I had the timeout set to 100 I believe if that effects anything. I was a bit perplexed on the 'passed' result of the memory tests when trying both 00 and FF. I figured that the 00 would always pass and FF always fail without being on target hardware.

>> c
CPU free running...
Interrupted
00.364675 : FFC3 : 00       : BRK
*** missing clock ***
>> test 0000 00ff 0
Memory test: Fixed 00: passed
*** missing clock ***
>> test 0000 00ff ff
Memory test: Fixed 00: passed
*** missing clock ***
>> crc 8000 ffff
Illegal command: crc 8000 ffff
>> crc 8000 ffff
Illegal command: crc 8000 ffff
>> test 0000 00ff -1

Not sure why, but after the 10 minutes, I got a test going from 0000 ffff with these messages...

Fail at FFEB (Wrote: 55, Read back 00)
Fail at FFEC (Wrote: 55, Read back 00)
Fail at FFED (Wrote: 55, Read back 00)
Fail at FFEE (Wrote: 55, Read back 00)
Fail at FFEF (Wrote: 55, Read back 00)
Fail at FFF0 (Wrote: 55, Read back 00)
Fail at FFF1 (Wrote: 55, Read back 00)
Fail at FFF2 (Wrote: 55, Read back 00)
Fail at FFF3 (Wrote: 55, Read back 00)
Fail at FFF4 (Wrote: 55, Read back 00)
Fail at FFF5 (Wrote: 55, Read back 00)
Fail at FFF6 (Wrote: 55, Read back 00)
Fail at FFF7 (Wrote: 55, Read back 00)
Fail at FFF8 (Wrote: 55, Read back 00)
Fail at FFF9 (Wrote: 55, Read back 00)
Fail at FFFA (Wrote: 55, Read back 00)
Fail at FFFB (Wrote: 55, Read back 00)
Fail at FFFC (Wrote: 55, Read back 00)
Fail at FFFD (Wrote: 55, Read back 00)
Fail at FFFE (Wrote: 55, Read back 00)
Fail at FFFF (Wrote: 55, Read back 00)
Memory test: Fixed 55: passed

Closed 2021-04-12.

Thread 24 (2022-07-06):

PCB for the (Z80) adapter board

scott8, 2022-07-06:
Dave,
I'd like a PCB for the (Z80) adapter board. Do you still have these?

Thanks,
Scott

scott8, 2022-07-06:
David,
I think the new alias ***@***.***" is not working.
If you'll email me directly at ***@***.***, I'll show you what I
found.
I don't want to put the location out on the github web site so I'd like you
to email me privately.

Thanks,
Scott
m: 602-309-8216

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

scott8, 2022-07-06:
Will this board work?

Features:

- Spartan 6 XC6SLX9 FPGA
- UART Port
- RS485 PORT
- 1 LED to show when the FPGA is correctly configured
- On board voltage regulation that can handle 5V
- 8PCS Programmed LEDS
- 4PCS Programmed Keys
- On board flash memory M25P16 to store the FPGA configuration file.

[image: xc6slx9.jpg]

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

hoglet67, 2022-07-07:
I don't see the attached imaged, but the description matches this board:
https://www.aliexpress.com/item/32887046050.html

Sorry no, that won't work, because the connector pinouts are different.

hoglet67, 2022-07-07:
The adapter PCB board would need to be redesigned to match the form factor/connector pinout, and then the FPGA pinput would likely need to be updated as well. It's alot of work, and by that time there are no guarantees the FPGA board will still be available.

It's a mugs game at this point!

scott8, 2022-07-07:
This one?

https://www.amazon.com/Developement-Spartan-6-Spartan3-Spartan-3e-XC3S250E/dp/B08MT36M2Z

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

scott8, 2022-07-07:
Any others:
https://www.google.com/search?q=Xilinx%20%20FPGA%20Spartan%206%20%20XC6SLX9%20Core%20Board

?

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

hoglet67, 2022-07-07:
I don't mean to be dismissive, but there is just not enough information to tell.

You need to get hold of:
- mechanical drawings that show the exact connector spacing
- schematics, that show the locations of the power supply pins on the connectors

To be honest, it's very unlikely that you'll find an exact match to the eepizza board, unless someone has literally cloned the design (which I don't think has happened).

This issue here is that the FPGA in pretty much unobtainable at the moment. Anyone who has stocks is selling the FPGA alone for ~$100. Once the FPGA becomes available again, then it's likely that the eepizza board will become available.

Have you reached out to eepizza? Depending on how much you are wiling to pay, he may be able to source parts to make a small number of boards.

hoglet67, 2022-07-07:
My only other suggestion is to make a wanted post on the stardot forum. I know several folk there bought this board and are possibly not using it. Again, depending on you much you are prepared to pay, someone may be willing to move theirs on.

hoglet67, 2022-07-08:
Sorry, I try not to share my email address...

If you want me to see it, then you can post it here, or on stardot.

scott8, 2022-07-08:
No problem.

See the attached PDF.
Post this far and wide.

Happy Trails,
Scott

On Fri, Jul 8, 2022 at 12:45 PM David Banks ***@***.***>
wrote:

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

hoglet67, 2022-07-09:
I think you possibly forgot to attach the PDF.

scott8, 2022-07-09:
No. It apparently won't go through.
That's why I wanted your email address.

Scott

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

scott8, 2022-07-09:
Here you go. It's been posted.

http://www.cpm.z80.de/license.html

Scott

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

scott8, 2022-10-11:
I have access to one a few.
I need to discuss details with you.
Please email me at ***@***.*** so we can discuss this offline.

Thanks,
Scott

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

hoglet67, 2022-10-11:
Scott,

It's not economic for me to post board to the US.

This project is open source, and the gerbers for the Z80 board are linked to here:
https://github.com/hoglet67/AtomBusMon/wiki/Z80-CPU-Adapter

It would be cheaper for you to order a batch of 5 boards directly from JLCPCB.

regards

Dave

Closed 2022-10-11.
