hoglet67/AtomBusMon/kicad/6809e/v1/6809e_adapter.pdf

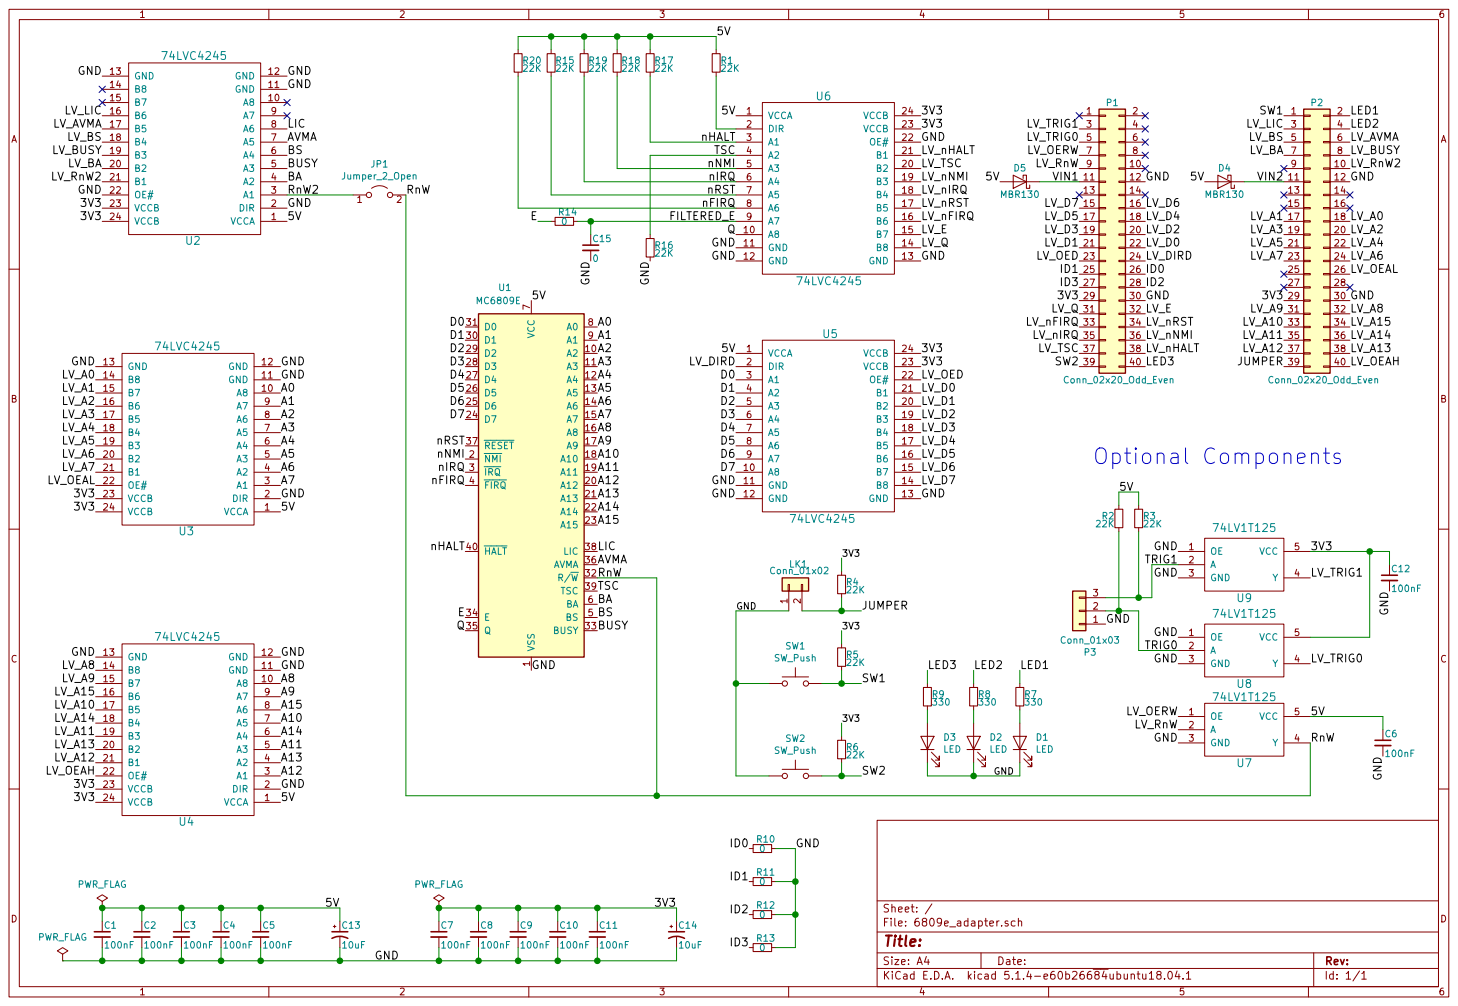
[picture p1: page 1]
