hoglet67/AtomBusMon/kicad/z80/v1/z80_adapter.pdf

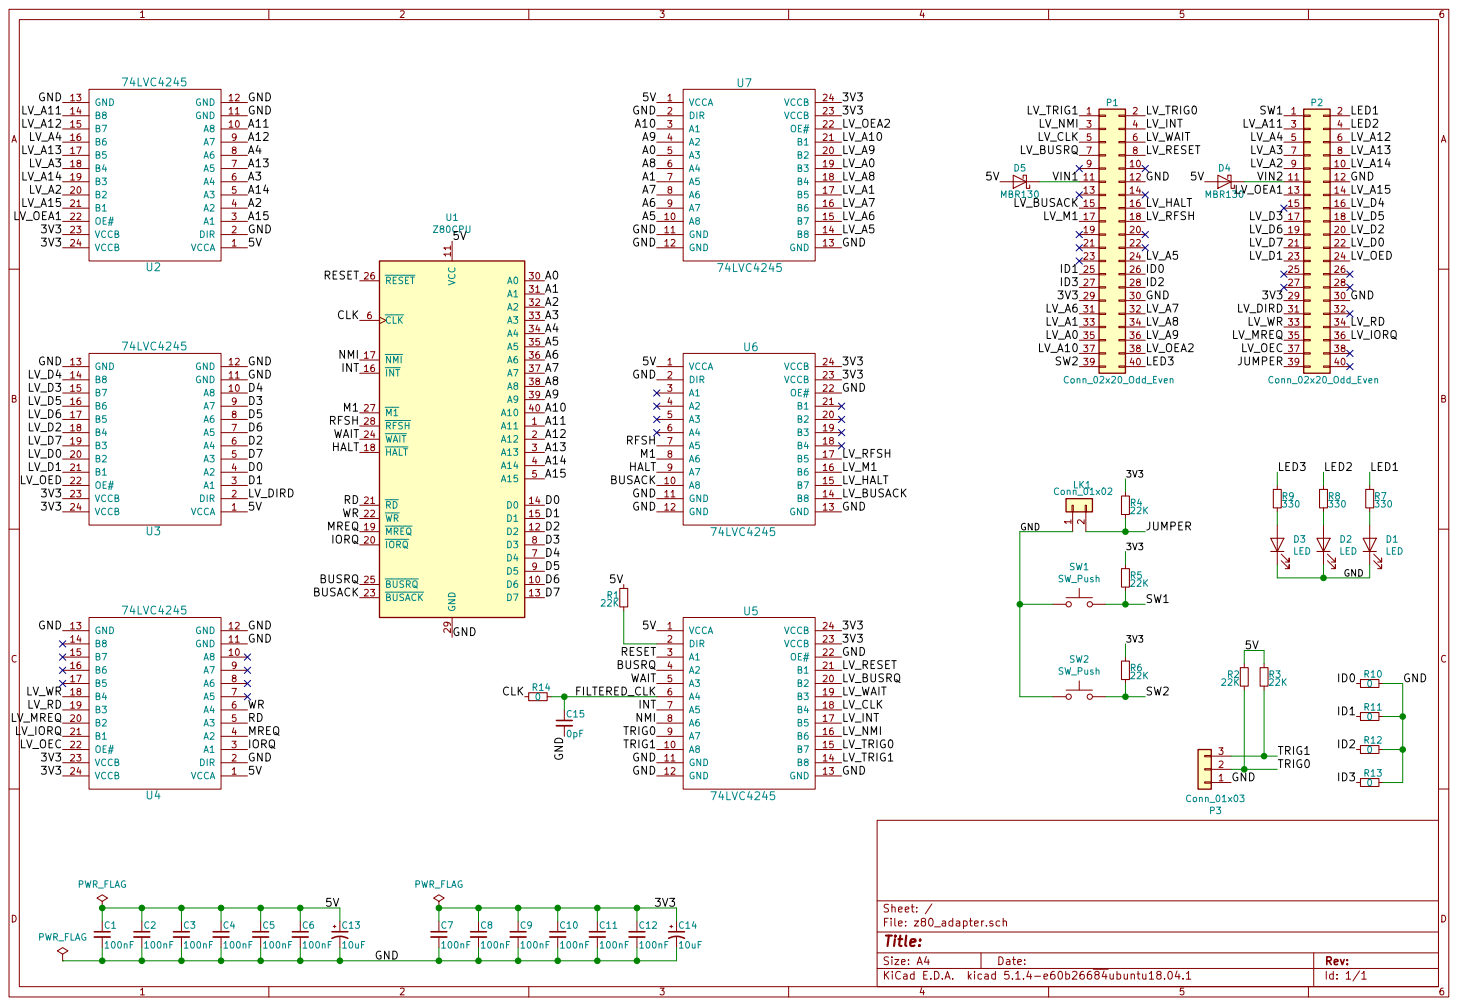
[picture p2: page 1]

RESET
ID3 BUSACK
CLK NMI
INT M1 RFSH WAIT HALTRD
