hoglet67/AtomBusMon/kicad/6502/v1/6502_adapter.pdf

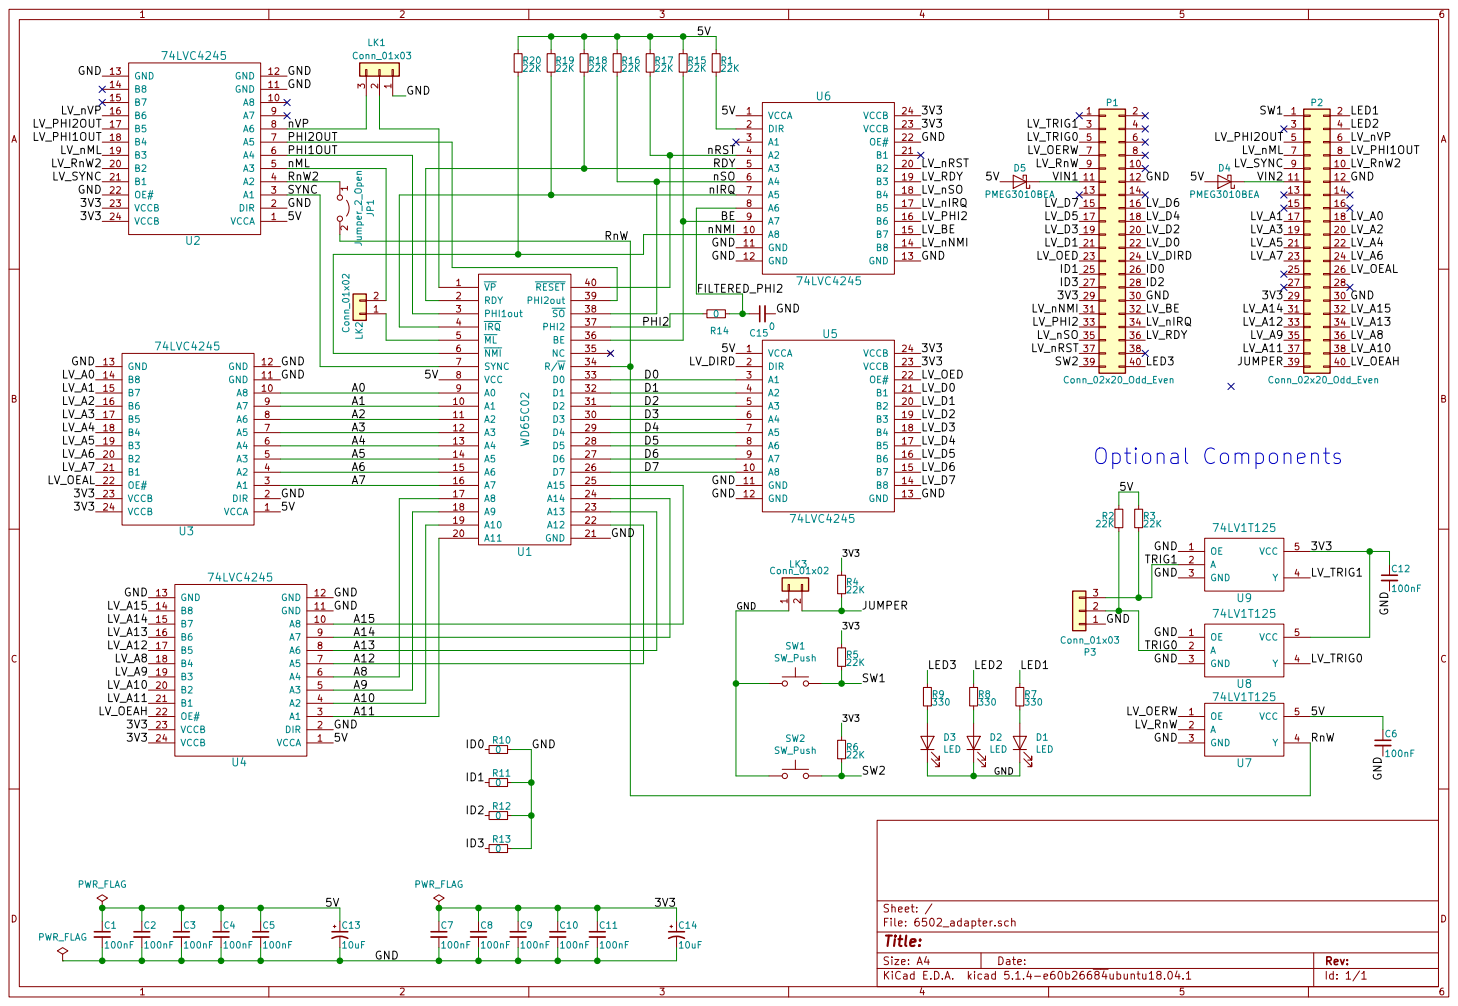
[picture p3: page 1]
