hoglet67/AtomBusMon/src/Z80CpuMon10CL006Kakigate.vhd

--------------------------------------------------------------------------------
-- Copyright (c) 2026 David Banks
--
--------------------------------------------------------------------------------
--   ____  ____
--  /   /\/   /
-- /___/  \  /
-- \   \   \/
--  \   \
--  /   /         Filename  : Z80CpuMon10CL006Kakigate.vhd
-- /___/   /\     Timestamp : 03/02/2026
-- \   \  /  \
--  \___\/\___\
--
--Design Name: Z80CpuMon10CL006Kakigate
--Device: 10CL006Kakigate8

library ieee;
use ieee.std_logic_1164.all;
use ieee.std_logic_unsigned.all;
use ieee.numeric_std.all;

entity Z80CpuMon10CL006Kakigate is
    generic (
        num_comparators   : integer := 8;        -- default value for lx9core board
        avr_prog_mem_size : integer := 1024 * 9  -- default value for lx9core board
        );
    port (
        clock           : in    std_logic;

        -- Z80 Signals
        RESET_n         : in    std_logic;
        CLK_n           : in    std_logic;
        WAIT_n          : in    std_logic;
        INT_n           : in    std_logic;
        NMI_n           : in    std_logic;
        BUSRQ_n         : in    std_logic;
        M1_n            : out   std_logic;
        MREQ_n          : out   std_logic;
        IORQ_n          : out   std_logic;
        RD_n            : out   std_logic;
        WR_n            : out   std_logic;
        RFSH_n          : out   std_logic;
        HALT_n          : out   std_logic;
        BUSAK_n         : out   std_logic;
        Addr            : out   std_logic_vector(15 downto 0);
        Data            : inout std_logic_vector(7 downto 0);

        -- Level Shifers Controls
        OEC_n           : out   std_logic;
        OEA1_n          : out   std_logic;
        OEA2_n          : out   std_logic;
        OED_n           : out   std_logic;
        DIRD            : out   std_logic;

        -- External trigger inputs
        trig            : in    std_logic_vector(1 downto 0);

        -- ID/mode inputs
        mode            : in    std_logic;
        id              : in    std_logic_vector(3 downto 0);

        -- Power monitoring
        monitor_uv_n    : in    std_logic;
        monitor_ov_n    : in    std_logic;

        -- Serial Console
        avr_RxD         : in    std_logic;
        avr_TxD         : out   std_logic;

        -- Switches
        sw               : in    std_logic_vector(4 downto 2);

        -- LEDs
        led              : out   std_logic_vector(4 downto 1)
        );
end Z80CpuMon10CL006Kakigate;

architecture behavioral of Z80CpuMon10CL006Kakigate is

    signal MREQ_n_int   : std_logic;
    signal IORQ_n_int   : std_logic;
    signal M1_n_int     : std_logic;
    signal RD_n_int     : std_logic;
    signal WR_n_int     : std_logic;
    signal RFSH_n_int   : std_logic;
    signal HALT_n_int   : std_logic;
    signal BUSAK_n_int  : std_logic;
    signal tristate_n   : std_logic;
    signal tristate_ad_n: std_logic;

    signal sw_reset_cpu : std_logic;
    signal sw_reset_avr : std_logic;
    signal led_bkpt     : std_logic;
    signal led_trig0    : std_logic;
    signal led_trig1    : std_logic;

    -- 50MHz clock, toggle every 25,000,000 =
    signal blinky_count : unsigned(24 downto 0) := (others => '0');
    signal led_blinky   : std_logic := '0';

begin

    -- Switches are active low
    sw_reset_cpu <= not sw(2);
    sw_reset_avr <= not sw(3);

    -- LEDs are active low
    led(1)       <= not led_bkpt;
    led(2)       <= (not led_trig0) and monitor_ov_n;
    led(3)       <= (not led_trig1) and monitor_uv_n;
    led(4)       <= led_blinky and sw(2) and sw(3);

    -- 1Hz Blinky LED
    process(clock)
    begin
        if rising_edge(clock) then
            if blinky_count = to_unsigned(24999999, blinky_count'length) then
                blinky_count <= (others => '0');
                led_blinky <= not led_blinky;
            else
                blinky_count <= blinky_count + 1;
            end if;
        end if;
    end process;

    wrapper : entity work.Z80CpuMon
        generic map (
            ClkMult           => 12,
            ClkDiv            => 25,
            ClkPer            => 20.000,
            num_comparators   => num_comparators,
            avr_prog_mem_size => avr_prog_mem_size
            )
        port map (
            clock             => clock,

            -- Z80 Signals
            RESET_n           => RESET_n,
            CLK_n             => CLK_n,
            WAIT_n            => WAIT_n,
            INT_n             => INT_n,
            NMI_n             => NMI_n,
            BUSRQ_n           => BUSRQ_n,
            M1_n              => M1_n_int,
            MREQ_n            => MREQ_n_int,
            IORQ_n            => IORQ_n_int,
            RD_n              => RD_n_int,
            WR_n              => WR_n_int,
            RFSH_n            => RFSH_n_int,
            HALT_n            => HALT_n_int,
            BUSAK_n           => BUSAK_n_int,
            Addr              => Addr,
            Data              => Data,

            -- Buffer Control Signals
            DIRD              => DIRD,
            tristate_n        => tristate_n,
            tristate_ad_n     => tristate_ad_n,

            -- Mode jumper, tie low to generate NOPs when paused
            mode              => mode,

            -- External trigger inputs
            trig              => trig,

            -- Serial Console
            avr_RxD           => avr_RxD,
            avr_TxD           => avr_TxD,

            -- Switches
            sw_reset_cpu      => sw_reset_cpu,
            sw_reset_avr      => sw_reset_avr,

            -- LEDs
            led_bkpt          => led_bkpt,
            led_trig0         => led_trig0,
            led_trig1         => led_trig1,

            -- OHO_DY1 connected to test connector
            tmosi             => open,
            tdin              => open,
            tcclk             => open,

            -- Debugging signals
            test1             => open,
            test2             => open,
            test3             => open,
            test4             => open
            );

    -- Z80 Outputs
    MREQ_n  <= MREQ_n_int;
    IORQ_n  <= IORQ_n_int;
    M1_n    <= M1_n_int;
    RD_n    <= RD_n_int;
    WR_n    <= WR_n_int;
    RFSH_n  <= RFSH_n_int;
    HALT_n  <= HALT_n_int;
    BUSAK_n <= BUSAK_n_int;

    -- Level Shifter Controls
    OEC_n   <= not tristate_n;
    OEA1_n  <= not tristate_ad_n;
    OEA2_n  <= not tristate_ad_n;
    OED_n   <= not tristate_ad_n;

end behavioral;
