hoglet67/AtomBusMon/src/altera/DCM0.vhd

library ieee;
use ieee.std_logic_1164.all;
use ieee.numeric_std.all;

LIBRARY altera_mf;
USE altera_mf.all;

entity DCM0 is
    generic (
       ClkMult        : integer := 10;       -- default value correct for GODIL
       ClkDiv         : integer := 31;       -- default value correct for GODIL
       ClkPer         : real    := 20.345    -- default value correct for GODIL
       );
    port (CLKIN_IN  : in  std_logic;
          CLKFX_OUT : out std_logic);
end DCM0;

architecture BEHAVIORAL of DCM0 is

	COMPONENT altpll
	GENERIC (
		clk0_divide_by		: NATURAL;
		clk0_duty_cycle		: NATURAL;
		clk0_multiply_by		: NATURAL;
		clk0_phase_shift		: STRING;
--		clk1_divide_by		: NATURAL;
--		clk1_duty_cycle		: NATURAL;
--		clk1_multiply_by		: NATURAL;
--		clk1_phase_shift		: STRING;
--		clk2_divide_by		: NATURAL;
--		clk2_duty_cycle		: NATURAL;
--		clk2_multiply_by		: NATURAL;
--		clk2_phase_shift		: STRING;
		compensate_clock		: STRING;
		gate_lock_signal		: STRING;
		inclk0_input_frequency		: NATURAL;
		intended_device_family		: STRING;
		invalid_lock_multiplier		: NATURAL;
		lpm_hint		: STRING;
		lpm_type		: STRING;
		operation_mode		: STRING;
		port_activeclock		: STRING;
		port_areset		: STRING;
		port_clkbad0		: STRING;
		port_clkbad1		: STRING;
		port_clkloss		: STRING;
		port_clkswitch		: STRING;
		port_configupdate		: STRING;
		port_fbin		: STRING;
		port_inclk0		: STRING;
		port_inclk1		: STRING;
		port_locked		: STRING;
		port_pfdena		: STRING;
		port_phasecounterselect		: STRING;
		port_phasedone		: STRING;
		port_phasestep		: STRING;
		port_phaseupdown		: STRING;
		port_pllena		: STRING;
		port_scanaclr		: STRING;
		port_scanclk		: STRING;
		port_scanclkena		: STRING;
		port_scandata		: STRING;
		port_scandataout		: STRING;
		port_scandone		: STRING;
		port_scanread		: STRING;
		port_scanwrite		: STRING;
		port_clk0		: STRING;
		port_clk1		: STRING;
		port_clk2		: STRING;
		port_clk3		: STRING;
		port_clk4		: STRING;
		port_clk5		: STRING;
		port_clkena0		: STRING;
		port_clkena1		: STRING;
		port_clkena2		: STRING;
		port_clkena3		: STRING;
		port_clkena4		: STRING;
		port_clkena5		: STRING;
		port_extclk0		: STRING;
		port_extclk1		: STRING;
		port_extclk2		: STRING;
		port_extclk3		: STRING;
		valid_lock_multiplier		: NATURAL
	);
	PORT (
			areset	: IN STD_LOGIC ;
			clk	: OUT STD_LOGIC_VECTOR (5 DOWNTO 0);
			inclk	: IN STD_LOGIC_VECTOR (1 DOWNTO 0);
			locked	: OUT STD_LOGIC
	);
	END COMPONENT;

	signal clk : std_logic_vector (5 downto 0);
	signal inclk : std_logic_vector (1 downto 0);

begin

	altpll_component : altpll
	GENERIC MAP (
		clk0_divide_by => ClkDiv,
		clk0_duty_cycle => 50,
		clk0_multiply_by => ClkMult,
		clk0_phase_shift => "0",
		compensate_clock => "CLK0",
		gate_lock_signal => "NO",
		inclk0_input_frequency => 20000,
		intended_device_family => "Cyclone IV",
		invalid_lock_multiplier => 5,
		lpm_hint => "CBX_MODULE_PREFIX=pll32",
		lpm_type => "altpll",
		operation_mode => "NORMAL",
		port_activeclock => "PORT_UNUSED",
		port_areset => "PORT_UNUSED",
		port_clkbad0 => "PORT_UNUSED",
		port_clkbad1 => "PORT_UNUSED",
		port_clkloss => "PORT_UNUSED",
		port_clkswitch => "PORT_UNUSED",
		port_configupdate => "PORT_UNUSED",
		port_fbin => "PORT_UNUSED",
		port_inclk0 => "PORT_USED",
		port_inclk1 => "PORT_UNUSED",
		port_locked => "PORT_UNUSED",
		port_pfdena => "PORT_UNUSED",
		port_phasecounterselect => "PORT_UNUSED",
		port_phasedone => "PORT_UNUSED",
		port_phasestep => "PORT_UNUSED",
		port_phaseupdown => "PORT_UNUSED",
		port_pllena => "PORT_UNUSED",
		port_scanaclr => "PORT_UNUSED",
		port_scanclk => "PORT_UNUSED",
		port_scanclkena => "PORT_UNUSED",
		port_scandata => "PORT_UNUSED",
		port_scandataout => "PORT_UNUSED",
		port_scandone => "PORT_UNUSED",
		port_scanread => "PORT_UNUSED",
		port_scanwrite => "PORT_UNUSED",
		port_clk0 => "PORT_USED",
		port_clk1 => "PORT_UNUSED",
		port_clk2 => "PORT_UNUSED",
		port_clk3 => "PORT_UNUSED",
		port_clk4 => "PORT_UNUSED",
		port_clk5 => "PORT_UNUSED",
		port_clkena0 => "PORT_UNUSED",
		port_clkena1 => "PORT_UNUSED",
		port_clkena2 => "PORT_UNUSED",
		port_clkena3 => "PORT_UNUSED",
		port_clkena4 => "PORT_UNUSED",
		port_clkena5 => "PORT_UNUSED",
		port_extclk0 => "PORT_UNUSED",
		port_extclk1 => "PORT_UNUSED",
		port_extclk2 => "PORT_UNUSED",
		port_extclk3 => "PORT_UNUSED",
		valid_lock_multiplier => 1
	)
	PORT MAP (
		inclk => inclk,
		clk => clk
	);

   inclk <= '0' & CLKIN_IN;
   CLKFX_OUT <= clk(0);

end BEHAVIORAL;
