hoglet67/AtomBusMon/(commit log)

2015-06-07 Added 6502 reset functionality
    [AtomBusMon.c]
2015-06-10 Redesigned interface between AVR and Bus Monitor to be command based
    [AtomBusMon.c]
2015-06-11 Removed interrupt and address commands; update LCD display in continue loop
2015-06-11 Added synchronous reset to FIFO
    [AtomBusMon.c]
2015-06-17 Added a register for Din which resolved issue on Beeb, upped version to 0.26
    [AtomBusMon.c, AtomCpuMon.vhd]
2015-06-17 Changed to timing of writes slightly as AtomMMC was occasionally failing on New Atom with 0.26. Verified on Beeb. Upped version to 0.27
    [AtomBusMon.c, AtomCpuMon.vhd]
2015-06-18 Added a jumper enabled fakeTube register at 0xFEE0 with value 0xFE to work around a beeb issue with pullups, incremented version to 0.28
    [AtomBusMon.c, AtomCpuMon.vhd]
2015-06-19 Fixed write breakpoints to stop immediately; switched back to T65 core
    [AtomCpuMon.vhd]
2015-06-19 Fixed a bug where I had broken watches by doing memory reads while the 6502 was running
    [AtomBusMon.c]
2015-06-20 Fixed a bug in the logging of memory errors; incremented version to 0.35
    [AtomBusMon.c]
2015-06-27 Switched to Timing-Driven Packing, fixed a bug with instr wait states that meant single stepping executed RST 38 because FF was read off databus; increased comparators to 8; incremented version to 0.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
    [AtomBusMon.c]
2015-06-29 Fixed a problem with breakpoints running on one instruction on the Z80, version now 0.46
    [AtomBusMon.c]
2015-06-30 Implemented IO watches/breakpoints; fixed a bug with stepping through CB/DD/ED/FD prefixed opcodes which have 2 M1 cycles; version not 0.47
    [AtomBusMon.c]
2015-07-02 Shrunk the 6809 disassembler; version now 0.50; silly mistake
    [dis6809.c]
2015-07-04 Increased Z80 drive to 4mA, as 2mA is barely sufficient to counter the 1K5 GODIL pullups
2015-07-04 Some small bug fixes
    [AtomBusMon.c, dis6809.c]
2015-07-04 Reworked the 6809 single stepping to hide the fact that register writes are pipelined
    [MC6809ECpuMon.vhd]
2015-07-04 Corrected the function of EXTAL and XTAL; version now 0.53
    [AtomBusMon.c, MC6809ECpuMon.vhd]
2015-08-08 Updated 6809 clocking scheme; tested on Dragon 32 and Simple 6809; fixed 6809 reset command bug; version now 0.64
    [AtomBusMon.c, MC6809ECpuMon.vhd]
2015-10-26 In ICE-T65 fixed the timing of ICE initiated read/write cycles to give them a whole cycle
    [AtomCpuMon.vhd]
2015-10-26 Reworked the 6502 single stepping to hide the fact that register writes are pipelined
    [AtomBusMon.c, AtomCpuMon.vhd]
2015-10-27 ICT T65: Fixed an issue the caused an immediate NMI on a Beeb Model B
    [AtomBusMon.c, AtomCpuMon.vhd]
2015-10-27 ICE T65: Fixed the single stepping issue with AlanD's core (sync bug); increased CCLK rate to 25MHz
    [AtomCpuMon.vhd, R65Cx2.vhd]
2015-10-31 Refactor: 1st stage
2015-10-31 Refactor: 2nd stage
2015-10-31 Refactor: 2nd stage - bug fixes
    [AtomBusMon.c, AtomCpuMon.vhd, MOS6502CpuMonCore.vhd]
2015-11-11 Fixed AlanD core 65C02 bugs: D was being set in IRQ/BRK; sync was inferring a latch
    [R65Cx2.vhd]
2015-11-15 Updated reset output to avoid the use of a tristate signal in BusMonCore
    [AtomCpuMon.vhd]
2015-11-15 Refactored AtomFast6502 to use new MOS6502CpuMonCore - works in new Atom at 4MHz and with tube
2015-11-15 Only return will interrupt continue; version now 0.72
2017-07-25 Initial check-in of an 6502 specfic level shifter for the LX9 Core board
    [6502_adapter.kicad_pcb, 6502_adapter.sch]
2017-07-25 Rotate board 180 + add mounting holes
    [6502_adapter.kicad_pcb]
2017-07-25 PCB: clened up silk screen
    [6502_adapter.kicad_pcb]
2017-07-25 PCB: Cosmetic adjustment to IC positions
    [6502_adapter.kicad_pcb]
2017-07-25 LX9 support: in Z80CpuMon made the switch/led polarity configurable with generics
2017-07-26 LX9 support: corrected pin assignment in Z80CpuMonLX9Jason.ucf
2017-07-29 On LX9 board, updated Tx=51 and Rx=55
2017-08-01 Swapped names of sw_interrupt_n and sw_reset_n (as they were wrong way around)
    [AtomCpuMon.vhd, MC6809ECpuMon.vhd]
2017-08-09 Added build for a flipped version of Jason's level shifter, so USB comes out at the pin 1 end (better for Beeb)
2018-11-20 Checked in initial work on lx9_dave target (see full comment)
    The .ucf files look like they are for a completely different board
    (the lx9 starter board, not the epizza board). So these need to be
    reworked completely.
    Also, the following signals needs adding to the top level 6502 design:
    - OEAH (output)
    - OEAL (output)
    - OED (output)
    - ML (output)
    - VP (output)
    - BE (input)
    The system will not work without some attention to these.
    Minimally, in the FPGA design we can tie them as follows:
    - OEAH (output) - set to 0 (address bus always enabled)
    - OEAL (output) - set to 0 (ditto)
    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
2018-11-20 PCB: Migrated to KiCad 5.0
    [6502_adapter.kicad_pcb, 6502_adapter.sch]
2018-12-21 LX9 6502: Move fakeTube input to p112 (next to a GND)
2019-09-10 Updated to kicad 5.1.4
    [6502_adapter.kicad_pcb, 6502_adapter.sch]
2019-09-10 Renamed kicad to 6502/v1
    [6502_adapter.kicad_pcb, 6502_adapter.sch]
2019-09-10 Kicad: v2 of 6502 board, work in progress
    [6502_adapter.kicad_pcb, 6502_adapter.sch]
2019-09-10 Kicad: tidy up old rescue libraries
    [6502_adapter.kicad_pcb, 6502_adapter.sch]
2019-09-10 Kicad: remove old netlist
2019-09-10 Kicad v2: associate 3D shapes
    [6502_adapter.kicad_pcb]
2019-09-11 Kicad v2: complete routing
    [6502_adapter.kicad_pcb, 6502_adapter.sch]
2019-09-11 Kicad v2: move links to bottom side
    [6502_adapter.kicad_pcb, 6502_adapter.sch]
2019-09-13 Kicad v2: tidy up silk screen
    [6502_adapter.kicad_pcb, 6502_adapter.sch]
2019-09-13 Kicad v2: more tidying; add logo
    [6502_adapter.kicad_pcb]
2019-09-13 Kicad v2: Made U7-9 optional
    [6502_adapter.kicad_pcb, 6502_adapter.sch]
2019-09-13 Kicad v2: tidy silk screen
    [6502_adapter.kicad_pcb, 6502_adapter.sch]
2019-09-13 Kicad v2: rename links
    [6502_adapter.kicad_pcb, 6502_adapter.sch]
2019-09-13 Kicad v2: pullups now 22K
    [6502_adapter.kicad_pcb, 6502_adapter.sch]
2019-09-13 Kicad v2: added build for manufacturing files
    [6502_adapter.kicad_pcb]
2019-09-15 Kicad v2: added board ID inputs
    [6502_adapter.kicad_pcb, 6502_adapter.sch]
2019-09-15 Kicad: Added Z80 adapter
    [z80_adapter.kicad_pcb, z80_adapter.sch]
2019-09-15 Kicad: 6502 - updated references
    [6502_adapter.kicad_pcb, 6502_adapter.sch]
2019-09-15 Kicad: z80 - silk screen
    [z80_adapter.kicad_pcb]
2019-09-15 Kicad: 6502 - improve 5V feed
    [6502_adapter.kicad_pcb]
2019-09-17 Revert accidental change to MC6809ECpuMon
    [MC6809ECpuMon.vhd]
2019-09-17 ICE-6809: Added glitch filtering to E
    [MC6809ECpuMon.vhd]
2019-09-20 Kicad 6502: added clock filtering
    [6502_adapter.kicad_pcb, 6502_adapter.sch]
2019-09-20 Kicad z80: added clock filtering
    [z80_adapter.kicad_pcb, z80_adapter.sch]
2019-09-20 Kicad 6502: deleted old v1 design
    [6502_adapter.kicad_pcb, 6502_adapter.sch]
2019-09-20 Kicad 6502: renamed v2 to v1
    [6502_adapter.kicad_pcb, 6502_adapter.sch]
2019-09-22 Kicad 6502: final tweaks
    [6502_adapter.kicad_pcb]
2019-09-22 Kicad 6502: add more power vias
    [6502_adapter.kicad_pcb]
2019-09-22 Kicad z80: add more power vias
    [z80_adapter.kicad_pcb]
2019-09-22 Kicad z80: change via sizes
    [z80_adapter.kicad_pcb]
2019-09-22 Kicad 6502: change via sizes
    [6502_adapter.kicad_pcb]
2019-09-22 Kicad 6502: added manufacturing files
    [6502_adapter.gbl, 6502_adapter.gbo, 6502_adapter.gbs, 6502_adapter.gko, 6502_adapter.gtl, 6502_adapter.gto, 6502_adapter.gts, 6502_adapter.xln]
2019-09-22 Kicad z80: added manufacturing files
    [z80_adapter.gbl, z80_adapter.gbo, z80_adapter.gbs, z80_adapter.gko, z80_adapter.gtl, z80_adapter.gto, z80_adapter.gts, z80_adapter.xln]
2019-10-01 Kicad 6809e: Initial schematic and layout
    [6809e_adapter.kicad_pcb, 6809e_adapter.sch]
2019-10-03 z80: fixed an error in board.ucf in the previous commit
2019-10-15 z80: temporarily disable IORQ_inhibit
    The fixed unreliable IM2 interrupts on the Acorn Z80 Co Pro
2019-10-15 z80: updated T80 to version 350
    Copyright (c) 2018 Sorgelig
    Taken from https://github.com/EisernSchild/t80/commit/cbaa6450b
    Changes I needed to make afterwards:
    1. Fixup T80_Pack.vhd (missing params)
    2. Replace T80a.vhd with my own version
    [regsz80.c]
2019-10-16 Use CPU_65C02 for defined as CPU == 65C02 doesn't work
    [AtomBusMon.c, AtomBusMon.h]
2019-10-17 6502/65C02: Add power up reset generation (AlanD 65C02 core needs this)
    [AtomBusMon.c, MOS6502CpuMonCore.vhd]
2019-10-18 kicad 6502: added weak pullups to 6502 control signals
    [6502_adapter.kicad_pcb, 6502_adapter.sch]
2019-10-22 Kicad 6809: fix SOT323; add weak pullup/downs
    [6809e_adapter.kicad_pcb, 6809e_adapter.sch]
2019-10-23 Kicad: added PDF schematics
2019-10-24 Kicad 6502: manufacturing files for v1.1
    [6502_adapter.gbl, 6502_adapter.gbo, 6502_adapter.gbs, 6502_adapter.gko, 6502_adapter.gtl, 6502_adapter.gto, 6502_adapter.gts, 6502_adapter.xln]
2019-10-24 Kicad 6809: manufacturing files for v1.0
    [6809e_adapter.gbl, 6809e_adapter.gbo, 6809e_adapter.gbs, 6809e_adapter.gko, 6809e_adapter.gtl, 6809e_adapter.gto, 6809e_adapter.gts, 6809e_adapter.xln]
2019-10-24 Firmware: remove manual step in cmdContinue (no longer needed on 6502 or Z80)
    [AtomBusMon.c]
2019-10-25 Z80: support interrupt masking in hardware
2019-10-27 Firmware: fix build error when CPU_EMBEDDED undefined
    [AtomBusMon.c]
2019-10-31 Firmware: correct a superfluous warning message
    [AtomBusMon.c]
2019-10-31 Firmware: Use unsigned char for trigger, fix bugs in trigger command
    [AtomBusMon.c]
2019-11-02 BusMonCore: clean up switch/led names
2019-11-03 6502: correctly display MSB of SP (fixes #2)
    [regs6502.c]
2019-11-04 All: refactor reset logic, add debouncing
    [MOS6502CpuMonCore.vhd]
2019-11-04 All: rename switches to represent their real function
2019-11-04 All: fix issues at low cpu clock speeds using proper handshaking instead of fixed delays
    [AtomBusMon.c]
2019-11-04 65c02: correct value shown an PC
    [R65Cx2.vhd]
2019-11-07 Firmware: type change bug in crc command
    [AtomBusMon.c]
2019-11-09 Firmware: fix issue with overflowing data space using progmem strings
    [AtomBusMon.c]
2019-11-09 Firmware: fix minor logging bug
    [AtomBusMon.c]
2019-11-09 Firmware: add clock/timeout error detection
    [AtomBusMon.c]
2019-11-09 Firmware: return inserts blank link
2019-11-09 Firmware: Use ESC [ K to blank line
2019-11-10 Firmware: reworked 65(c)02 disassembler
    [AtomBusMon.h, dis.h, dis6502.c, dis65c02.c, status.c, status.h]
2019-11-10 Firmware: reworked status to avoid log0
    [AtomBusMon.c, status.c, status.h]
2019-11-11 Z80: improve register formatting, fix flags
    [regsz80.c]
2019-11-15 6502: fix buffer overrun in disassembler
    [dis6502.c, dis65c02.c]
2019-11-15 Firmware: Improve missing parameter checking on commands (#7)
    [AtomBusMon.c, AtomBusMon.h, status.c, status.h]
2020-01-29 65C02: BE pin now operates as DBE (works in BBC Master)
2020-05-17 Firware: Fix a race condition when single stepping at slow (<= 1MHz) clock rates
    [AtomBusMon.c]
2020-06-17 6502: fix duplicate break/watchpoints when Rdy in use
    [MOS6502CpuMonCore.vhd]
2020-06-21 Make commands 6-bits, add Special and TimerMode commands
2020-06-21 Extend TimerMode command with prescale and reset address
    [AtomBusMon.c]
2021-03-13 R65C02: correct cycle counts of JMP (ind) and JMP (ind,x) to 6
    [R65Cx2.vhd]
2021-03-20 Z80: Rd/Wr Mem/IO breakpoint/watchpoint sampled in middle of T3
2021-03-21 Z80: Sample IM2 vector at start of T3, not middle
2021-07-04 Z80: fix display of int/nmi/halted state
    [disz80.c]
2021-11-18 Replace special command with x interrupt control commands
    [AtomBusMon.c, AtomBusMon.h, MOS6502CpuMonCore.vhd]
2025-01-29 65C02: Reset exec_held in MOS6502CpuMonCore (fixes issue with BeebFpga/Gowin)
    [MOS6502CpuMonCore.vhd]
2025-11-25 Altera: Add some pin assignments
2025-11-25 Altera: Switch speed grade from 7 to 8
2025-11-26 Firmware: Fix a compiler warning
    [AtomBusMon.c]
2025-11-26 Altera: Add pins for all switches/leds; add 1Hz blinky
2025-11-26 Altera: Swap connectors A and B in pin assignment as board will be inverted
2025-11-29 Altera: Invert polarity of LEDs 2,3 and 4
    [MC6809CpuMonEP4CE6E22C.vhd, Z80CpuMonEP4CE6E22C.vhd]
