hoglet67/AtomBusMon/(notices)

Notices in the files:
firmware/dis6809.c:
This program is free software; you can redistribute it and/or modify
it under the terms of the GNU General Public License as published by
the Free Software Foundation; either version 2, or (at your option)
kicad/z80/v1/z80_adapter.kicad_pcb:
© 2019 Hoglet - Version 1.00
kicad/6502/v1/6502_adapter.kicad_pcb:
© 2019 Hoglet - Version 1.10
